ssteejans/thesis/Testing/Grid of Points/IMG_7849.JPG

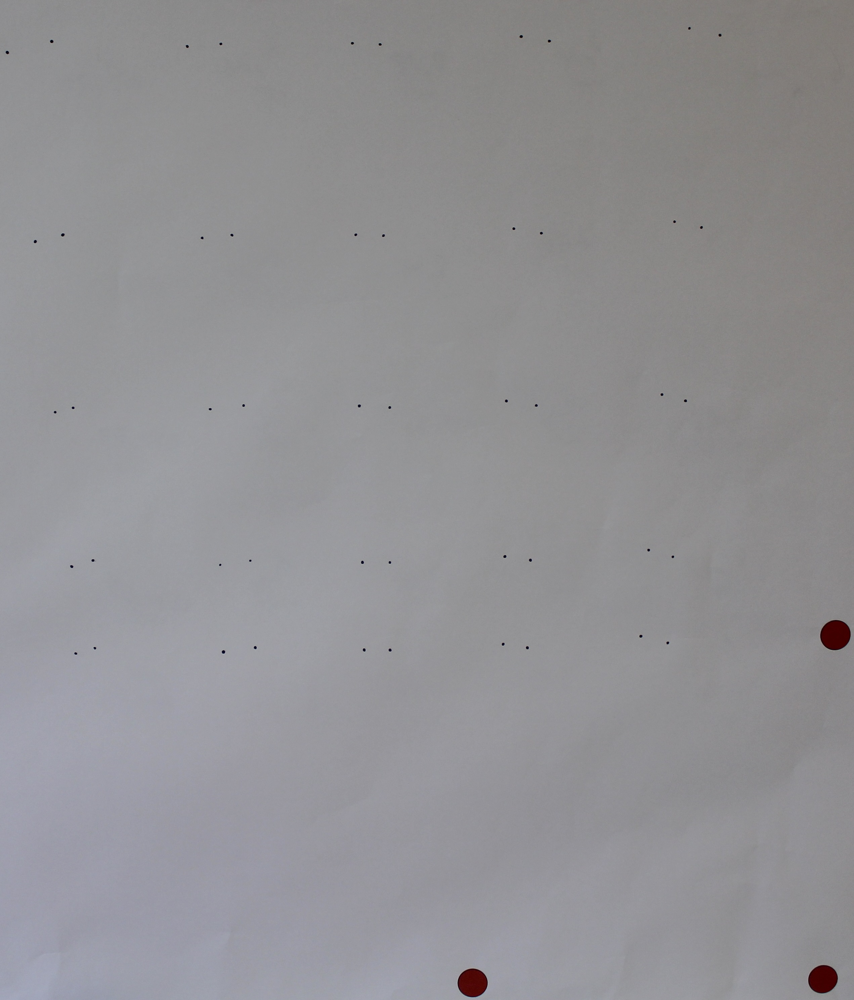
Testing/Grid of Points/IMG_7849.JPG
