ssteejans/thesis/Images/OTA Rotator.PNG

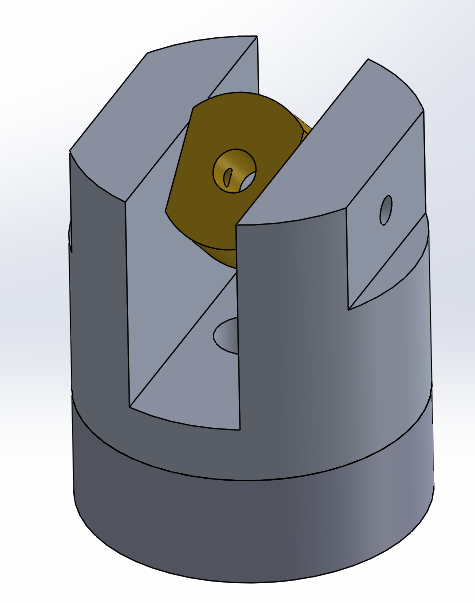
Images/OTA Rotator.PNG
