ssteejans/thesis/README.md

# thesis
Repository for thesis project
Author: Samuel Artho-Bentz
