ssteejans/thesis/Figures to be generated.rtf

To Do:
• Sections
o Title page
o Acknowledgement
o Abstract
o 2.1.3.2 angles of interest
o 2.1.3.3 Home Position
o 3.2.1 Time Derivative of a transformation matrix
o 3.3 Pointing a telescope
▪ RA/Dec to AltAz
o 4.2.1 Change from gear motor to stepper needs expanding
o 4.3.1 Talk about how to add micropython to board
o 4.3.3 What exactly the shoe of brian does
o 4.4 more discussion about advntages of python.
▪ discuss why Python is good for this system (easier and quicker development; easy for other users to modify; AstroPy provides LOTS of functionality; the system is generally slow so we don’t need the speed of C/C++/Assembly)
o All testing needs conclusions from each test
o 5.2.4 needs full description of wobble test
• Figures
o 5.2.2
▪ Frame capture of laser at starting point and ending point with note of time in between
• for each of the 4 tests
▪ Table with data
o 5.2.4
▪ lots of photos...but I need to figure out what the hell to do with this section

• Equations
o 3.2.1
▪ Time derivative of a transformation matrix
o 3.3
▪ Will need equations showing how latitude, longitude, right ascension, declination, and time -> altitude, azimuth, and rotation.
▪ http://aa.usno.navy.mil/faq/docs/Alt_Az.php
▪ http://spiff.rit.edu/classes/phys373/lectures/radec/radec.html
▪ http://ads.harvard.edu/books/1989fcm..book/Chapter2.pdf
o 4.2.1.3
• Things to do/discuss still
o Future Refinements & Summary should be combined into “Conclusions”
▪ Here is what I did
▪ Here are the results
▪ Here is what can be done to improve
• Refer to design section
• Automated homing
o Make sure all tests are well defined
▪ They all need discussion
▪ Quantify as much as possible
• Altitude Repeatability – “Repeatability was to within the tip of the marking pen, ~3mm”
• Explain any aberrations – starting point and repeating point are not the same – slop in system
• Altitude Relative Test
o Show plot of commanded angle vs angle error (Cmd-Actual)
o Develop design guidelines
▪ Geometry
• Modify matlab program for polar plot (theta-azimuth, r- altitude, hold image rotation to a constant angle)
▪ Linear Actuators
• What bearings are required
• How to pick motors
• Ball Screws vs Acme
▪ Rotators
• Compare to u-joint – get socket u joint to play with and think through if it would have singularity / other issues
• Bearings suggestions
o Appendices
▪ Doxygen Manual
• Doxygen.org to install doxygen
• doxypy or doxypypy to process files
• doxygen manual in appendix. code on github
▪ Drawings of any parts I made
• Frame
▪ Stepper motor spec sheet
• Ridgely
o Get instructions on adding Micropython to nucleo
o Shoe of Brian info for Appendices
• Presentation
o 25-40 min presentation followed by questions
o “Here is the thing I came up with” – just testing someone else’s stuff isn’t sufficient
▪ “I have created a design and test methodology”
o
