ssteejans/thesis/rotationMatrices.docx

RotX(θ)=[1, 0, 00, cosθ, -sinθ0, sinθ, cosθ]

RotZ(θ)=[cosθ, -sinθ, 0sinθ, cosθ, 00, 0, 1]

RotY(θ)=[cosθ, 0, sinθ0, 1, 0-sinθ, 0, cosθ]

sTb=[c(ϕ_(rot) ), -s(ϕ_(rot) ), 0s(ϕ_(rot) ), c(ϕ_(rot) ), 00, 0, 1][c(θ_(rot) ), -s(θ_(rot) ), 0s(θ_(rot) ), c(θ_(rot) ), 00, 0, 1][1, 0, 00, c(-θ_(alt) ), -s(-θ_(alt) )0, s(-θ_(alt) ), c(-θ_(alt) )]

[1, 0, 00, c(ϕ_(alt) ), -s(ϕ_(alt) )0, s(ϕ_(alt) ), c(ϕ_(alt) )][c(-θ_(az) ), 0, s(-θ_(az) )0, 1, 0-s(-θ_(az) ), 0, c(-θ_(az) )][c(ϕ_(az) ), 0, s(ϕ_(az) )0, 1, 0-s(ϕ_(az) ), 0, c(ϕ_(az) )]

θ_(altitude new) = θ_(altitude current) +ω_(altitude) *t_(step)

θ_(azimuth new) = θ_(azimuth current) +ω_(azimuth) *t_(step)

θ_(rotation new) = θ_(rotation current) +ω_(rotation) *t_(step)

L_(1 new) =f(θ_(altitude new) , θ_(azimuth new) , θ_(rotation new) )

V_1 =(L_(1 new) -L_(1 current))/(t_(step))
