ssteejans/thesis/Code/rtf/refman.rtf

Three Degree of Freedom Parallel Actuator Telescope Mount

AUTHOR
Version
Thu Jul 11 2019

Table of Contents

Table of contents

Hierarchical Index
Class Hierarchy
This inheritance list is sorted roughly, but not completely, alphabetically:
l6470nucleo.Dual6470 pagenum
object
ActuatorDriver.Actuator pagenum
TelescopeDriver.Telescope pagenum

Class Index
Class List
Here are the classes, structs, unions and interfaces with brief descriptions:
ActuatorDriver.Actuator (Object which represents one linear actuator for a 3 DOF parallel actuator telescope mount ) pagenum
l6470nucleo.Dual6470 (This class implements a driver for the dual L6470 stepping motor driver chips on a Nucleo IHM02A1 board ) pagenum
TelescopeDriver.Telescope (This class creates a telescope object controlled by 3 parallel actuators ) pagenum

File Index
File List
Here is a list of all documented files with brief descriptions:
ActuatorDriver.py (This file contains a driver for a linear actuator for use in a 3 DOF parallel actuator telescope mount ) pagenum
BitUtilities.py (Contains function to take the twos complement ) pagenum
l6470nucleo.py (This file contains a driver for a dual L6470 stepper driver board which is part of the Nucleo package from ST Micro ) pagenum
main.py (Control file for a Three Degree of Freedom Parallel Actuator Telescope Mount ) pagenum
TelescopeDriver.py (This file contains a driver for a Three Parallel actuator telescope ) pagenum

Class Documentation
ActuatorDriver.Actuator Class Reference
AAAAAAAABSAAAAAAAABS
Object which represents one linear actuator for a 3 DOF parallel actuator telescope mount.
Inheritance diagram for ActuatorDriver.Actuator:
IMAGE
Public Member Functions
def __init__ (self, stepPerLength, motorController, motorNumber)
Initialize the Actuator object.

def commandVelocity (self, velocity)
Commands the actuator to move at a specified velocity.

def commandLength (self, length)
Commands the actuator to move to a specific length.

def getCurrentLength (self)
Reads the stepcount of the motor and converts to length.

def findHome (self)
commands the actuator to slowly shorten.

def isHome (self)
Checks if the motor is stalled.

def resetPosition (self)
Defines the current position as zero steps.

def stop (self)
Commands the actuator to come to a soft stop.

Public Attributes
stepPerLength
The number of steps the stepper motor must take in order to move a distance.

controller
The motor controller associated with the actuator.

motorNumberAAAAAAAABTAAAAAAAABT
The motor to be used from the controller.

currentLengthAAAAAAAABUAAAAAAAABU
Variable to track the length of the actuator.

Detailed Description
Object which represents one linear actuator for a 3 DOF parallel actuator telescope mount.

Parameters:
stepPerLength | Total resolution of the actuator: STEPPER_RESOLUTION*SCREW_RESOLUTION*MICROSTEPS
motorController | Object which controls the motor: l6470nucleo.Dual6470
motorNumber | Motor selection for the l6470nucleo.Dual6470: 1 or 2

Constructor & Destructor Documentation
def ActuatorDriver.Actuator.__init__ ( self, stepPerLength, motorController, motorNumber)
AAAAAAAABVAAAAAAAABV
Initialize the Actuator object.

Member Function Documentation
ActuatorDriver.Actuator.commandLength ( self, length)
AAAAAAAABWAAAAAAAABW
Commands the actuator to move to a specific length.
Length unit is defined by the stepPerLength parameter.
Parameters:
length | [length]
ActuatorDriver.Actuator.commandVelocity ( self, velocity)
AAAAAAAABXAAAAAAAABX
Commands the actuator to move at a specified velocity.
Length unit is defined by the stepPerLength parameter.
Parameters:
velocity | [length/sec]
ActuatorDriver.Actuator.findHome ( self)
AAAAAAAABYAAAAAAAABY
commands the actuator to slowly shorten.
WARNING: no automatic stop is built into this function
ActuatorDriver.Actuator.getCurrentLength ( self)
AAAAAAAABZAAAAAAAABZ
Reads the stepcount of the motor and converts to length.

Returns:
currentLength the current length of the actuator
ActuatorDriver.Actuator.isHome ( self)
AAAAAAAACAAAAAAAAACA
Checks if the motor is stalled.
WARNING: results were not consistent and where very dependent on motor tuning.
ActuatorDriver.Actuator.resetPosition ( self)
AAAAAAAACBAAAAAAAACB
Defines the current position as zero steps.
Used for defining the home position.
ActuatorDriver.Actuator.stop ( self)
AAAAAAAACCAAAAAAAACC
Commands the actuator to come to a soft stop.

Member Data Documentation
ActuatorDriver.Actuator.controller
AAAAAAAACDAAAAAAAACD
The motor controller associated with the actuator.

ActuatorDriver.Actuator.stepPerLength
AAAAAAAACEAAAAAAAACE
The number of steps the stepper motor must take in order to move a distance.
Defines the units of length throughout the system.

The documentation for this class was generated from the following file:
ActuatorDriver.py

l6470nucleo.Dual6470 Class Reference
AAAAAAAACFAAAAAAAACF
This class implements a driver for the dual L6470 stepping motor driver chips on a Nucleo IHM02A1 board.
Public Member Functions
def __init__ (self, spi_object, cs_pin, stby_rst_pin)
Initialize the Dual L6470 driver.

def run (self, motor, steps_per_sec)
Tell the motor to run at the given speed.

def StepClock (self, direc=None)
Switch the motor to StepClock mode.

def Move (self, motor, steps, direc=None)
Tell motor driver motor to move num_steps in the direction direction .

def GoTo (self, motor, pos_steps)
This command asks the specified motor to move to the specified position.

def GoTo_DIR (self, motor, pos_steps, direc)
NOT IMPLEMENTED

def GoUntil (self, motor, action, steps_per_sec, direction)
NOT IMPLEMENTED

def ReleaseSW (self, motor, action, direc)
NOT IMPLEMENTED

def GoHome (self, motor)
NOT IMPLEMENTED

def GoMark (self, motor)
NOT IMPLEMENTED

def ResetPos (self, motor)
This command sets the given motor driver's absolute position register to zero.

def ResetDevice (self, motor)
NOT IMPLEMENTED

def softStop (self, motor)
Tell a motor driver to decelerate its motor and stop wherever it ends up after the deceleration.

def HardStop (self, motor)
Tell the specified motor to stop immediately, not even doing the usual smooth deceleration.

def SoftHiZ (self, motor)
Tell the specified motor to decelerate smoothly from its motion, then put the power bridges in high-impedance mode, turning off power to the motor.

def HardHiZ (self, motor)
Tell the specified motor to stop and go into high-impedance mode (no current is applied to the motor coils) immediately, not even doing the usual smooth deceleration.

def GetStatus (self, motor, verbose=0)
Gets the value of the STATUS register for the specified motor .

def getPositions (self, motor)
Get the positions stored in the drivers for the selected motor.

def isStalled (self, motor, homing=False)
Checks if the specified motor is stalled.

def Print_Status (self, motor, status)
Formatted printing of status codes for the driver.

Public Attributes
cs_pin
The CPU pin connected to the Chip Select (AKA 'Slave Select') pin of both the L6470 drivers.

stby_rst_pin
The CPU pin connected to the STBY/RST pin of the 6470's.

spi
The SPI object, configured with parameters that work for L6470's.

Static Public Attributes
dictionary REGISTER_DICT = {}
Dictionary of user available registers and their addresses.

dictionary STATUS_DICT = {}
Dictionary for the STATUS register.

dictionary COMMAND_DICT = {}
Dictionary for Application Commands.

Detailed Description
This class implements a driver for the dual L6470 stepping motor driver chips on a Nucleo IHM02A1 board.
The two driver chips are connected in SPI daisy-chain mode, which makes communication a bit convoluted.
NOTE: One solder bridge needs to be moved for the IHM02A1 to work with unmodified MicroPython. Bridge SB34 must be disconnected, and bridge SB12 must be connected instead. This is because the SCK signal for which the board is shipped is not the one which MicroPython uses by default.
Parameters:
spi_object | A SPI object already initialized. used to talk to the driver chips, either 1 or 2 for most Nucleos
cs_pin | The pin which is connected to the driver chips' SPI chip select (or 'slave select') inputs, in a pyb.Pin object
stby_rst_pin | The pin which is connected to the driver chips' STBY/RST inputs, in a pyb.Pin object

Constructor & Destructor Documentation
def l6470nucleo.Dual6470.__init__ ( self, spi_object, cs_pin, stby_rst_pin)
AAAAAAAACGAAAAAAAACG
Initialize the Dual L6470 driver.
The modes of the CS and STBY/RST pins are set and the SPI port is set up correctly.

Member Function Documentation
l6470nucleo.Dual6470.getPositions ( self, motor)
AAAAAAAACHAAAAAAAACH
Get the positions stored in the drivers for the selected motor.
Each driver stores its motor's position in a 22-bit register. If only one position is needed, it's efficient to get both because the drivers are daisy-chained on the SPI bus, so we have to send two commands and read a bunch of bytes of data anyway.
Parameters:
motor | The motor whose position should be read, 1 or 2
Returns: The current positions of the selected motor
l6470nucleo.Dual6470.GetStatus ( self, motor, verbose = 0)
AAAAAAAACIAAAAAAAACI
Gets the value of the STATUS register for the specified motor .
Resets STATUS register warning flags. Exits the system from error state. Does not reset HiZ.
WARNING: resets warning flags and error state for both steppers attached to the L6470 Nucleo.
Parameters:
motor | The motor whose status register should be read, 1 or 2
verbose | Print the status register results if TRUE
l6470nucleo.Dual6470.GoHome ( self, motor)
AAAAAAAACJAAAAAAAACJ
NOT IMPLEMENTED

l6470nucleo.Dual6470.GoMark ( self, motor)
AAAAAAAACKAAAAAAAACK
NOT IMPLEMENTED

l6470nucleo.Dual6470.GoTo ( self, motor, pos_steps)
AAAAAAAACLAAAAAAAACL
This command asks the specified motor to move to the specified position.

Parameters:
motor | The motor to move, either 1 or 2
pos_steps | The position to which to move, in absolute steps
l6470nucleo.Dual6470.GoTo_DIR ( self, motor, pos_steps, direc)
AAAAAAAACMAAAAAAAACM
NOT IMPLEMENTED

l6470nucleo.Dual6470.GoUntil ( self, motor, action, steps_per_sec, direction)
AAAAAAAACNAAAAAAAACN
NOT IMPLEMENTED

l6470nucleo.Dual6470.HardHiZ ( self, motor)
AAAAAAAACOAAAAAAAACO
Tell the specified motor to stop and go into high-impedance mode (no current is applied to the motor coils) immediately, not even doing the usual smooth deceleration.
This command puts the motor into a freewheeling mode with no control of position except for the small holding torque from the magnets in a PM hybrid stepper. This will probably cause the motor to miss some steps and have an inaccurate position count.
Parameters:
motor | The motor to be turned off, 1 or 2
l6470nucleo.Dual6470.HardStop ( self, motor)
AAAAAAAACPAAAAAAAACP
Tell the specified motor to stop immediately, not even doing the usual smooth deceleration.
This command asks for nearly infinite acceleration of the motor, and will probably cause the motor to miss some steps and have an inaccurate position count.
Parameters:
motor | The motor to halt, 1 or 2
l6470nucleo.Dual6470.isStalled ( self, motor, homing = False)
AAAAAAAACQAAAAAAAACQ
Checks if the specified motor is stalled.
Did not work with all motors. Should be tested heavily before use.
Parameters:
motor | The motor to check for stall
homing | If TRUE, reset position when stalled
l6470nucleo.Dual6470.Move ( self, motor, steps, direc = None)
AAAAAAAACRAAAAAAAACR
Tell motor driver motor to move num_steps in the direction direction .

Parameters:
motor | The motor to move, either 1 or 2
steps | How many steps to move, in a 20 bit number
direc | The direction in which to move, either 0 for one way or nonzero for the other; if unspecified, the sign of the number of steps will be used, positive meaning direction 0
l6470nucleo.Dual6470.Print_Status ( self, motor, status)
AAAAAAAACSAAAAAAAACS
Formatted printing of status codes for the driver.

Parameters:
motor | The motor which the status is representing.
status | The code returned by a GetStatus call.
l6470nucleo.Dual6470.ReleaseSW ( self, motor, action, direc)
AAAAAAAACTAAAAAAAACT
NOT IMPLEMENTED

l6470nucleo.Dual6470.ResetDevice ( self, motor)
AAAAAAAACUAAAAAAAACU
NOT IMPLEMENTED

l6470nucleo.Dual6470.ResetPos ( self, motor)
AAAAAAAACVAAAAAAAACV
This command sets the given motor driver's absolute position register to zero.

Parameters:
motor | The motor whose position is to be zeroed, either 1 or 2
l6470nucleo.Dual6470.run ( self, motor, steps_per_sec)
AAAAAAAACWAAAAAAAACW
Tell the motor to run at the given speed.
The speed may be positive, causing the motor to run in direction 0, or negative, causing the motor to run in direction 1.
Parameters:
motor | The motor to move, either 1 or 2
steps_per_sec | The number of steps per second at which to go, up to the maximum allowable set in MAX_SPEED
l6470nucleo.Dual6470.SoftHiZ ( self, motor)
AAAAAAAACXAAAAAAAACX
Tell the specified motor to decelerate smoothly from its motion, then put the power bridges in high-impedance mode, turning off power to the motor.

Parameters:
motor | The motor to be turned off, 1 or 2
l6470nucleo.Dual6470.softStop ( self, motor)
AAAAAAAACYAAAAAAAACY
Tell a motor driver to decelerate its motor and stop wherever it ends up after the deceleration.

Parameters:
motor | The motor to halt, 1 or 2
l6470nucleo.Dual6470.StepClock ( self, direc = None)
AAAAAAAACZAAAAAAAACZ
Switch the motor to StepClock mode.

In StepClock mode the motor moves in response to the rising edge of a signal applied to the STCK pin.
NOT IMPLEMENTED
Parameters:
direc | Direction in which the motor should move on rising edge

Member Data Documentation
dictionary l6470nucleo.Dual6470.COMMAND_DICT = {}[static]
AAAAAAAADAAAAAAAAADA
Dictionary for Application Commands.
See L6470 Programming manual Pg 56 for information on usage. These commands must be OR'd with the values for use.
l6470nucleo.Dual6470.cs_pin
AAAAAAAADBAAAAAAAADB
The CPU pin connected to the Chip Select (AKA 'Slave Select') pin of both the L6470 drivers.

dictionary l6470nucleo.Dual6470.REGISTER_DICT = {}[static]
AAAAAAAADCAAAAAAAADC
Dictionary of user available registers and their addresses.

l6470nucleo.Dual6470.spi
AAAAAAAADDAAAAAAAADD
The SPI object, configured with parameters that work for L6470's.
pyb.SPI (spi_number, mode=pyb.SPI.MASTER, baudrate=2000000, polarity=1, phase=1, bits=8, firstbit=pyb.SPI.MSB)
dictionary l6470nucleo.Dual6470.STATUS_DICT = {}[static]
AAAAAAAADEAAAAAAAADE
Dictionary for the STATUS register.
Contains all error flags, as well as basic motor state information.
l6470nucleo.Dual6470.stby_rst_pin
AAAAAAAADFAAAAAAAADF
The CPU pin connected to the STBY/RST pin of the 6470's.

The documentation for this class was generated from the following file:
l6470nucleo.py

TelescopeDriver.Telescope Class Reference
AAAAAAAADGAAAAAAAADG
This class creates a telescope object controlled by 3 parallel actuators.
Inheritance diagram for TelescopeDriver.Telescope:
IMAGE
Public Member Functions
def __init__ (self, actuatorOne, actuatorTwo, actuatorThree)AAAAAAAADHAAAAAAAADH
Initialize the Telescope object.

def goVelocityAngular (self, omega_alt, omega_az, omega_rot, tstep=1)
Move the telescope at specified radians/sec.

def goToAngles (self, O_alt, O_az, O_rot, move=False)
Function which calculates the correct lengths of the three linear actuators in order to achieve the specified angles (in degrees) then can send the scope to that location.

def findHome (self)
Causes each actuator to shorten until it stalls then stops WARNING: Does not function!

def resetPositions (self)
Zeros the absolute position of each actuator.

def goToLengths (self, lengthOne, lengthTwo, lengthThree)
Commands each actuator to a specified length.

def goVelocity (self, velOne, velTwo, velThree)
Commands each actuator to move at a specified velocity.

Public Attributes
actuatorOneAAAAAAAADIAAAAAAAADI
actuatorOne: Right actuator when viewed from the origin looking along the X axis

actuatorTwoAAAAAAAADJAAAAAAAADJ
actuatorTwo: Left actuator when viewed from the origin looking along the X axis

actuatorThreeAAAAAAAADKAAAAAAAADK
actuatorThree: Rear, horizontal actuator

P0_bAAAAAAAADLAAAAAAAADL
Origin with respect to the base.

P1_bAAAAAAAADMAAAAAAAADM
Fixed end of actuator one.

P2_bAAAAAAAADNAAAAAAAADN
Fixed end of actuator two.

P3_bAAAAAAAADOAAAAAAAADO
Fixed end of actuator three.

OA_bAAAAAAAADPAAAAAAAADP
Optical Axis base.

P1_hAAAAAAAADQAAAAAAAADQ
Position of the moving end of actuator one in the home position.

P2_hAAAAAAAADRAAAAAAAADR
Position of the moving end of actuator two in the home position.

P3_hAAAAAAAADSAAAAAAAADS
Position of the moving end of actuator three in the home position.

OA_hAAAAAAAADTAAAAAAAADT
Position of the moving end of optical axis in the home position.

L_p1minAAAAAAAADUAAAAAAAADU
Minimum length of actuator one.

L_p2minAAAAAAAADVAAAAAAAADV
Minimum length of actuator two.

L_p3minAAAAAAAADWAAAAAAAADW
Minimum length of actuator three.

L_p1p2AAAAAAAADXAAAAAAAADX
Fixed distance from the moving end of actuator one to actuator two.

phi_azAAAAAAAADYAAAAAAAADY
The azimuth correction angle required to rotate from the home position to (0,0,0)

phi_altAAAAAAAADZAAAAAAAADZ
The altitude correction angle required to rotate from the home position to (0,0,0)

phi_rotAAAAAAAAEAAAAAAAAAEA
The image rotation correction angle required to rotate from the home position to (0,0,0)

alt_curAAAAAAAAEBAAAAAAAAEB
The current altitude of the system.

az_curAAAAAAAAECAAAAAAAAEC
The current azimuth of the system.

rot_curAAAAAAAAEDAAAAAAAAED
The current image rotation of the system.

Detailed Description
This class creates a telescope object controlled by 3 parallel actuators.
Each actuator is driven by a stepper motor with an L6470 stepper driver.
Parameters:
actuatorOne | Right actuator when viewed from the origin looking along the X axis
actuatorTwo | Left actuator when viewed from the origin looking along the X axis
actuatorThree | Rear, horizontal actuator

Member Function Documentation
TelescopeDriver.Telescope.findHome ( self)
AAAAAAAAEEAAAAAAAAEE
Causes each actuator to shorten until it stalls then stops WARNING: Does not function!
Non-functioning function which is designed to implement automatic home checking
TelescopeDriver.Telescope.goToAngles ( self, O_alt, O_az, O_rot, move = False)
AAAAAAAAEFAAAAAAAAEF
Function which calculates the correct lengths of the three linear actuators in order to achieve the specified angles (in degrees) then can send the scope to that location.

Parameters:
O_alt | Desired Altitude Angle in radians
O_az | Desired Azimuth Angle in radians
O_rot | Desired Rotation Angle in radians
move | Boolean value which determines if the function only calculates the required lengths or also commands motion
TelescopeDriver.Telescope.goToLengths ( self, lengthOne, lengthTwo, lengthThree)
AAAAAAAAEGAAAAAAAAEG
Commands each actuator to a specified length.

Parameters:
lengthOne | Desired length for actuator one
lengthTwo | Desired length for actuator two
lengthThree | Desired length for actuator three
TelescopeDriver.Telescope.goVelocity ( self, velOne, velTwo, velThree)
AAAAAAAAEHAAAAAAAAEH
Commands each actuator to move at a specified velocity.

Parameters:
velOne | Velocity in length/sec
velTwo | Velocity in length/sec
velThree | Velocity in length/sec
TelescopeDriver.Telescope.goVelocityAngular ( self, omega_alt, omega_az, omega_rot, tstep = 1)
AAAAAAAAEIAAAAAAAAEI
Move the telescope at specified radians/sec.

Parameters:
omega_az | Angular rate of azimuth (Rad/sec)
omega_alt | Angular rate of altitude (Rad/sec)
omega_rot | Angular rate of image rotation (Rad/sec)
tstep | time step for calculation of velocity. Default 1 sec
TelescopeDriver.Telescope.resetPositions ( self)
AAAAAAAAEJAAAAAAAAEJ
Zeros the absolute position of each actuator.
Used for defining the home position.

The documentation for this class was generated from the following file:
TelescopeDriver.py

File Documentation
ActuatorDriver.py File Reference
AAAAAAAAAAAAAAAAAAAA
This file contains a driver for a linear actuator for use in a 3 DOF parallel actuator telescope mount.
Classes
class ActuatorDriver.Actuator
Object which represents one linear actuator for a 3 DOF parallel actuator telescope mount.

Detailed Description
This file contains a driver for a linear actuator for use in a 3 DOF parallel actuator telescope mount.

Author:
Samuel Steejans Artho-Bentz

BitUtilities.py File Reference
AAAAAAAAABAAAAAAAAAB
Contains function to take the twos complement.
Functions
def BitUtilities.GetTwosComplement (value, bits)AAAAAAAAACAAAAAAAAAC
Takes the twos complement.

Detailed Description
Contains function to take the twos complement.

Author:
: mecha31

l6470nucleo.py File Reference
AAAAAAAAADAAAAAAAAAD
This file contains a driver for a dual L6470 stepper driver board which is part of the Nucleo package from ST Micro.
Classes
class l6470nucleo.Dual6470
This class implements a driver for the dual L6470 stepping motor driver chips on a Nucleo IHM02A1 board.
Variables
l6470nucleo.MAX_SPEED = const (10)AAAAAAAAAEAAAAAAAAAE
Maximum speed for the motor; default 65, or ~992 steps/s.

l6470nucleo.ACCEL = const (12)AAAAAAAAAFAAAAAAAAAF
Acceleration for the motor; default 138, or 2008 steps/s^2.

l6470nucleo.DECEL = const (12)AAAAAAAAAGAAAAAAAAAG
Deceleration for the motor; default 138, or 2008 steps/s^2.

l6470nucleo.K_VAL = const (255)AAAAAAAAAHAAAAAAAAAH
The K_val constant for registers 0x09, 0x0A, 0x0B, 0x0C; default 0x29 = 41.

l6470nucleo.INT_SPEED = const (2307)AAAAAAAAAIAAAAAAAAAI
Intersection speed for register 0x0D; default 0x0408 = 1032.

l6470nucleo.ST_SLP = const (25)AAAAAAAAAJAAAAAAAAAJ
Startup slope for register 0x0E; default 0x19 = 25.

l6470nucleo.FN_SLP = const (255)AAAAAAAAAKAAAAAAAAAK
Final slope for registers 0x0F, 0x10; default 0x29 = 41.

int l6470nucleo.STEP_SEL = 4
Number of Microsteps, num which are powers of 2 up to 128 are acceptable.

l6470nucleo.SYNC_EN = const(0x00)
Define SYNC_ENable bitmask.

l6470nucleo.SYNC_SEL = const(0x10)
SYNC_SEL modes.

l6470nucleo.STALL_TH = const(13)
STALL_TH.

Detailed Description
This file contains a driver for a dual L6470 stepper driver board which is part of the Nucleo package from ST Micro.
It can control each of the two L5470 chips which are on the board.
In order to use a stepping motor, the constants MAX_SPEED , ACCEL , etc . need to be tuned for that motor using the methods shown at http://www.st.com/resource/en/application_note/dm00061093.pdf .
Author:
JR Ridgely, Samuel Steejans Artho-Bentz

Variable Documentation
l6470nucleo.STALL_TH = const(13)
AAAAAAAAALAAAAAAAAAL
STALL_TH.
Default of 2.03A pg 47 of L6470 Programming Manual for details
int l6470nucleo.STEP_SEL = 4
AAAAAAAAAMAAAAAAAAAM
Number of Microsteps, num which are powers of 2 up to 128 are acceptable.

l6470nucleo.SYNC_EN = const(0x00)
AAAAAAAAANAAAAAAAAAN
Define SYNC_ENable bitmask.
0x80 for High, 0x00 for Low
l6470nucleo.SYNC_SEL = const(0x10)
AAAAAAAAAOAAAAAAAAAO
SYNC_SEL modes.
Datasheet pg 46 for full information

main.py File Reference
AAAAAAAAAPAAAAAAAAAP
Control file for a Three Degree of Freedom Parallel Actuator Telescope Mount.
Functions
def main.estop ()
commands all motors to halt immediately.

def main.Go (speed)
commands all motors to go at the specified speed.

def main.getPos ()AAAAAAAAAQAAAAAAAAAQ
Queries the actuators for their current lengths.

def main.getStatus (motornumber)
Requests the status of the specified motor.

def main.testRepeatability (numloops=10)
Runs through a series of points numloops times.

def main.testGrid ()
Moves to a series of points and waits for user input at each one.

Variables
main.STEPPER_RESOLUTION = const (200)AAAAAAAAARAAAAAAAAAR
Stepper Resolution [steps/rev].

int main.MICROSTEPS = 4AAAAAAAAASAAAAAAAAAS
Number of microsteps This must match NUMBER_OF_MICROSTEPS in TelescopeDriver.py and STEP_SEL in l6470nucleo.py .

main.SCREW_RESOLUTION = const(16)AAAAAAAAATAAAAAAAAAT
Leadscrew Resolution [rev/in].

main.stby_rst_pin1 = pyb.Pin.cpu.B5AAAAAAAAAUAAAAAAAAAU
SPI one standby/reset pin.

main.stby_rst_pin2 = pyb.Pin.cpu.B3AAAAAAAAAVAAAAAAAAAV
SPI two standyby/reset pin.

main.nCS1 = pyb.Pin.cpu.A4AAAAAAAAAWAAAAAAAAAW
SPI one chip select pin.

main.nCS2 = pyb.Pin.cpu.A10AAAAAAAAAXAAAAAAAAAX
SPI two chip select pin.

int main.spi_number = 1AAAAAAAAAYAAAAAAAAAY
SPI number.

main.spi_object
spi object for motor drivers

main.Driver1 = l6470nucleo.Dual6470(spi_object,nCS1, stby_rst_pin1)AAAAAAAAAZAAAAAAAAAZ
l6470nucleo board object

main.Driver2 = l6470nucleo.Dual6470(spi_object,nCS2, stby_rst_pin2)AAAAAAAABAAAAAAAAABA
l6470nucleo board object

main.actuatorOne = ActuatorDriver.Actuator(STEPPER_RESOLUTION*SCREW_RESOLUTION*MICROSTEPS, Driver1, 1)AAAAAAAABBAAAAAAAABB
Right actuator when viewed from the origin looking along the X axis.

main.actuatorTwo = ActuatorDriver.Actuator(STEPPER_RESOLUTION*SCREW_RESOLUTION*MICROSTEPS, Driver1, 2)AAAAAAAABCAAAAAAAABC
Left actuator when viewed from the origin looking along the X axis.

main.actuatorThree = ActuatorDriver.Actuator(STEPPER_RESOLUTION*SCREW_RESOLUTION*MICROSTEPS, Driver2, 1)AAAAAAAABDAAAAAAAABD
Rear, horizontal actuator.

main.Telescope = TelescopeDriver.Telescope(actuatorOne, actuatorTwo, actuatorThree)AAAAAAAABEAAAAAAAABE
Define the telescope based on the actuators above.

Detailed Description
Control file for a Three Degree of Freedom Parallel Actuator Telescope Mount.

Author:
Samuel Steejans Artho-Bentz

Function Documentation
main.estop ()
AAAAAAAABFAAAAAAAABF
commands all motors to halt immediately.

def main.getStatus ( motornumber)
AAAAAAAABGAAAAAAAABG
Requests the status of the specified motor.

Parameters:
motornumber | The motor associated with the desired actuator: 1, 2, or 3
def main.Go ( speed)
AAAAAAAABHAAAAAAAABH
commands all motors to go at the specified speed.
directly communicates with the stepper motors.
Parameters:
speed | steps/second
main.testGrid ()
AAAAAAAABIAAAAAAAABI
Moves to a series of points and waits for user input at each one.
Used for testing.
def main.testRepeatability ( numloops = 10)
AAAAAAAABJAAAAAAAABJ
Runs through a series of points numloops times.
Waits for the user to hit a key before moving on to the next point. Used for testing.
Parameters:
numloops | Desired number of times the points should be gone through.

Variable Documentation
main.spi_object
AAAAAAAABKAAAAAAAABKInitial value: 1 = pyb.SPI (spi_number, mode=pyb.SPI.MASTER,
2 baudrate=2000000, polarity=1, phase=1,
3 bits=8, firstbit=pyb.SPI.MSB)
spi object for motor drivers

TelescopeDriver.py File Reference
AAAAAAAABLAAAAAAAABL
This file contains a driver for a Three Parallel actuator telescope.
Classes
class TelescopeDriver.Telescope
This class creates a telescope object controlled by 3 parallel actuators.
Functions
def TelescopeDriver.rootsumsquare (a, b)
Calculates the root sum square of two vectors of size 3.

def TelescopeDriver.matmul (a, b)
Multiplies two matrices together a * b .

def TelescopeDriver.RotX (rads)AAAAAAAABMAAAAAAAABM
Rotation matrix about the x axis.

def TelescopeDriver.RotY (rads)AAAAAAAABNAAAAAAAABN
Rotation matrix about the y axis.

def TelescopeDriver.RotZ (rads)AAAAAAAABOAAAAAAAABO
Rotation matrix about the z axis.

Variables
int TelescopeDriver.NUMBER_OF_MICROSTEPS = 4AAAAAAAABPAAAAAAAABP
Must define the number of microsteps to correct for oddity of stepper driver.

Detailed Description
This file contains a driver for a Three Parallel actuator telescope.

Author:
Samuel Steejans Artho-Bentz

Function Documentation
def TelescopeDriver.matmul ( a, b)
AAAAAAAABQAAAAAAAABQ
Multiplies two matrices together a * b .

Parameters:
a | [m x n] matrix
b | [n x o] matrix
def TelescopeDriver.rootsumsquare ( a, b)
AAAAAAAABRAAAAAAAABR
Calculates the root sum square of two vectors of size 3.

Parameters:
a | vector of size 3
b | vector of size 3
Returns: The root-sum-of-squares of the difference of a and b

Index
INDEX
