ssteejans/thesis/Thesis Solidmodel/8020Frame - Sheet1.pdf

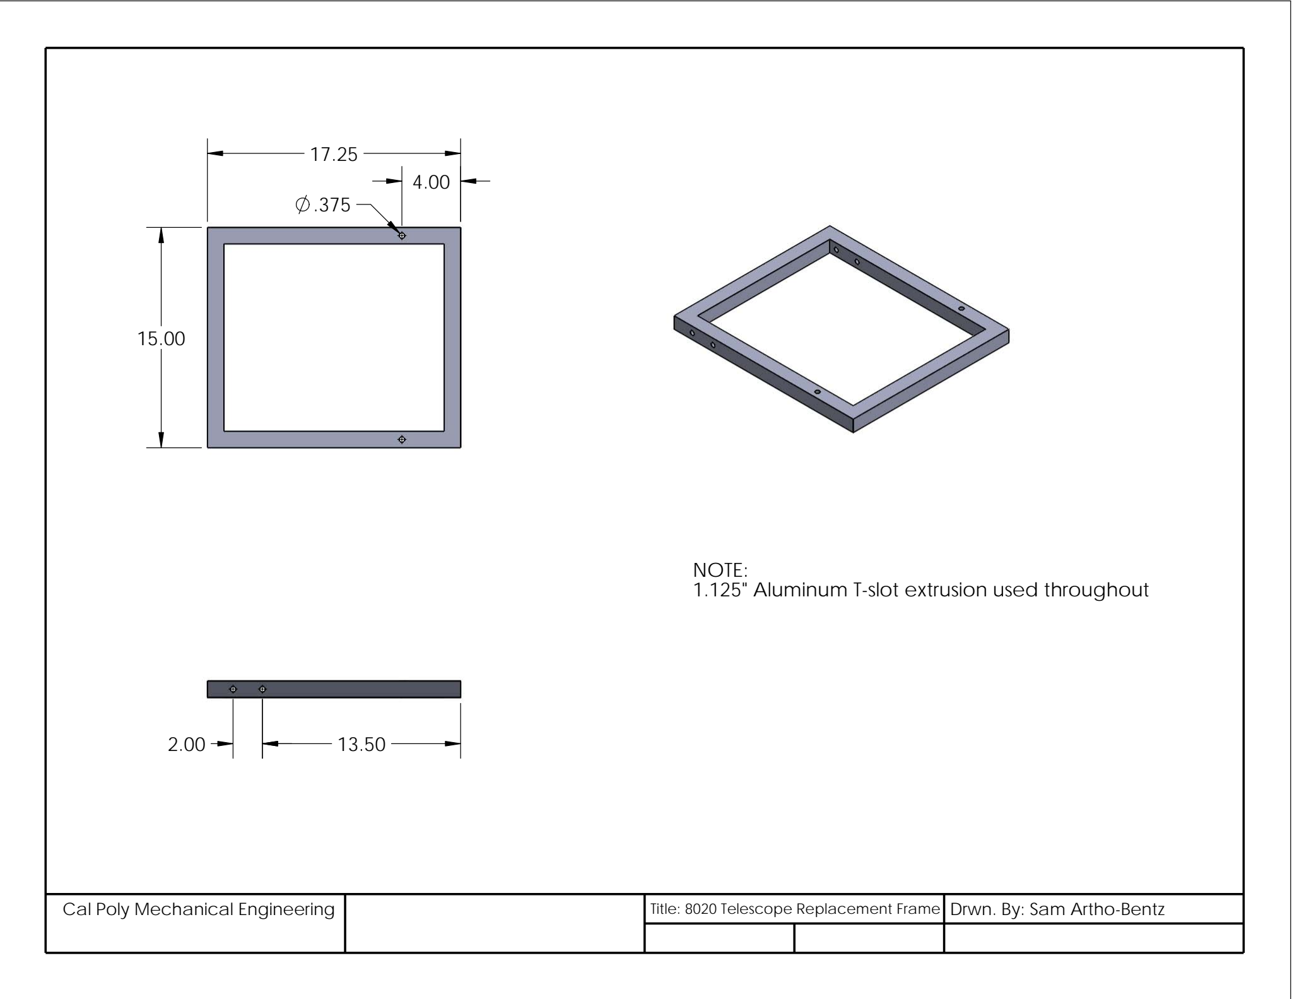
[picture p58: page 1]

2.00 | 13.50

4.00

17.25

15.00

.375

NOTE:
1.125" Aluminum T-slot extrusion used throughout
Cal Poly Mechanical Engineering | Title: 8020 Telescope Replacement Frame | Drwn. By: Sam Artho-Bentz
