ssteejans/thesis/Thesis Solidmodel/Dropdown - Sheet1.pdf

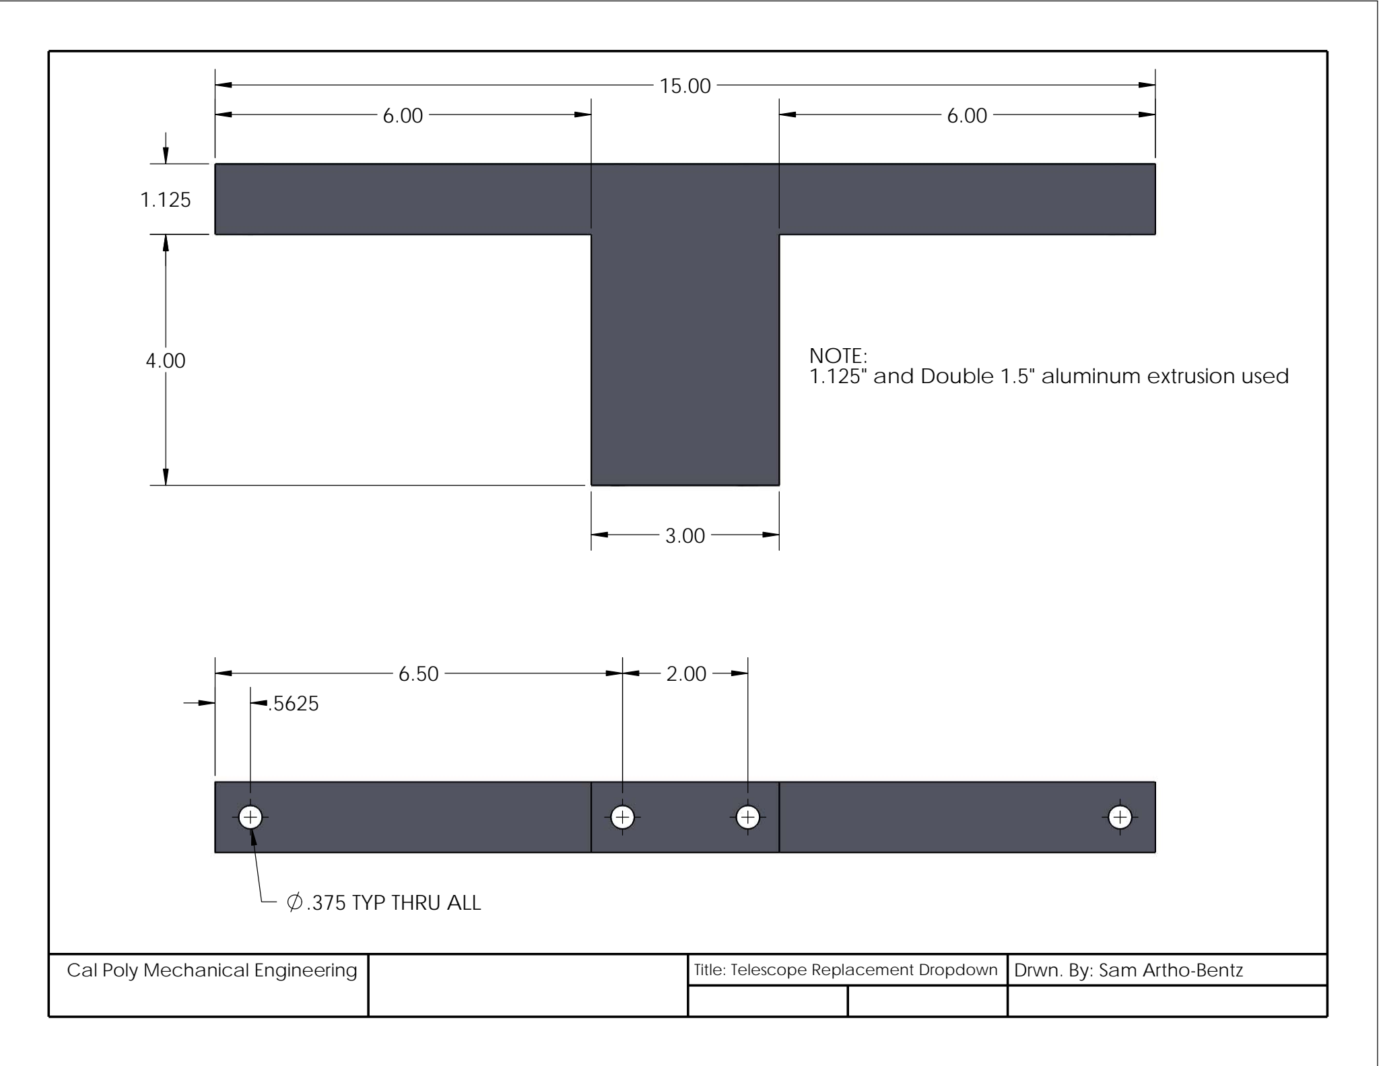
[picture p59: page 1]

Cal Poly Mechanical Engineering | Title: Telescope Replacement Dropdown | Drwn. By: Sam Artho-Bentz

NOTE:
1.125" and Double 1.5" aluminum extrusion used

6.00

15.00

1.125

3.00

4.00

6.00

6.50
.5625

2.00

.375 TYP THRU ALL
