ssteejans/thesis/Thesis Solidmodel/Backplate - Sheet1.pdf

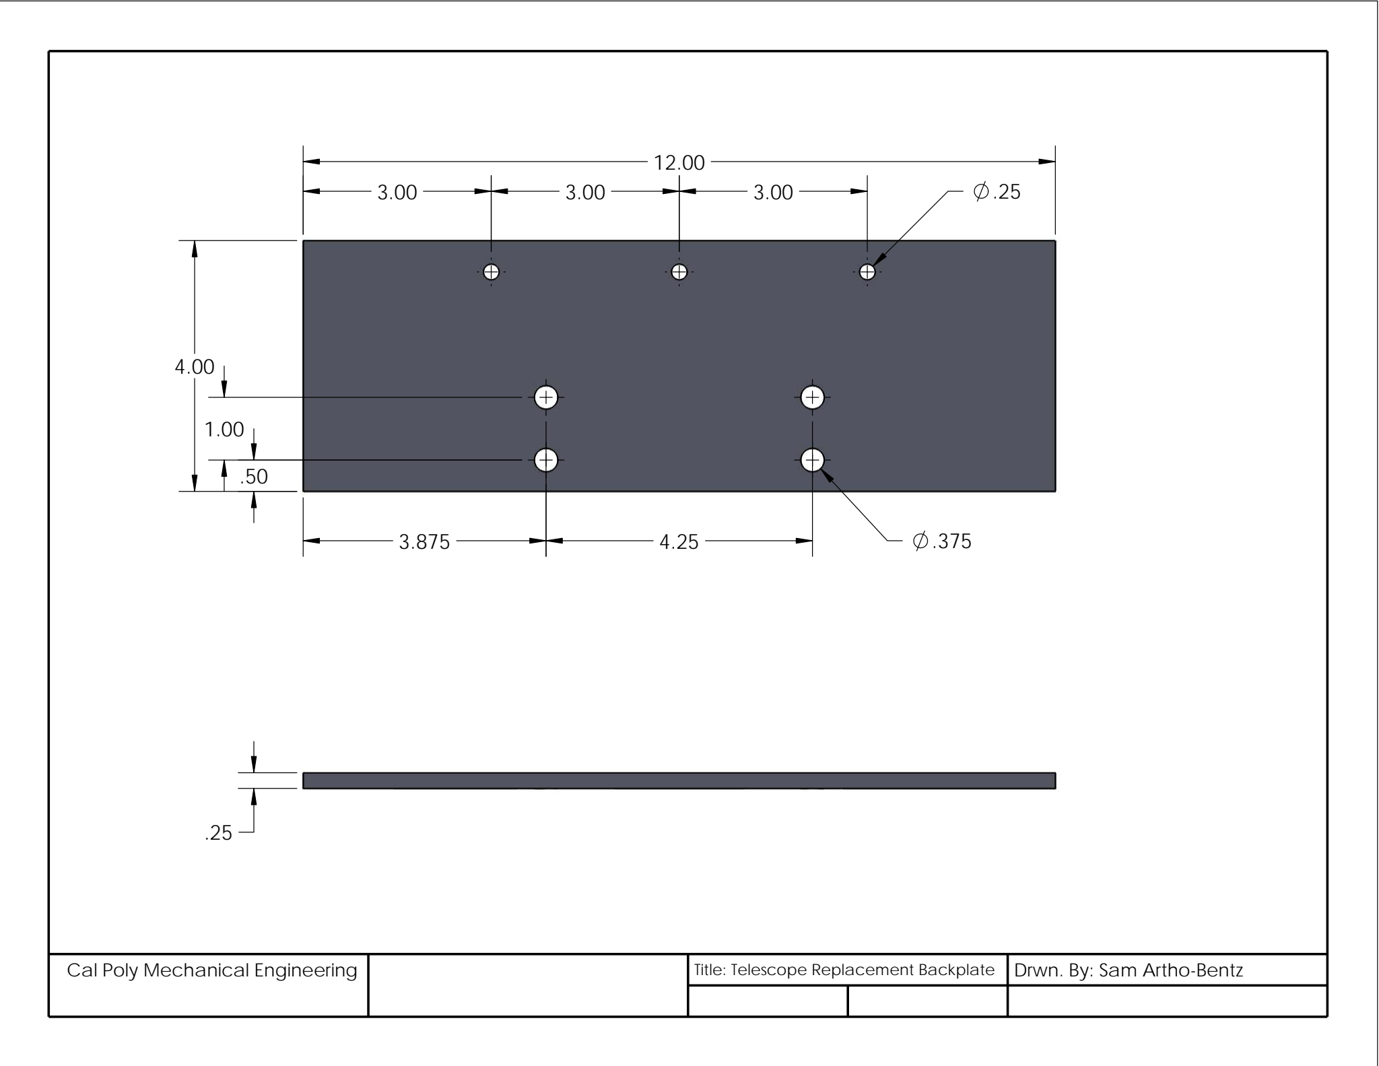
[picture p98: page 1]

Cal Poly Mechanical Engineering | Title: Telescope Replacement Backplate | Drwn. By: Sam Artho-Bentz

.375

4.00

12.00
3.00 | 3.00 | 3.00

4.25

1.00

.50

3.875

.25

.25
