ssteejans/thesis/Images/Board Trig.pdf

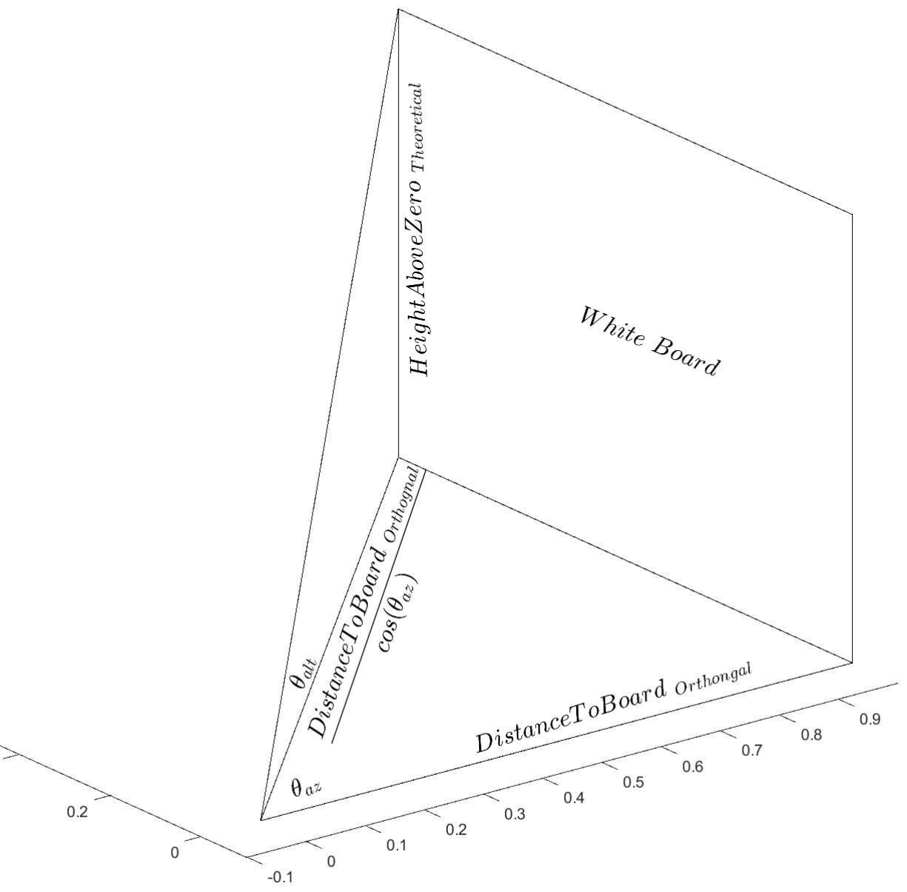
[picture p99: page 1]
