ssteejans/thesis/Images/Board Trig2.pdf

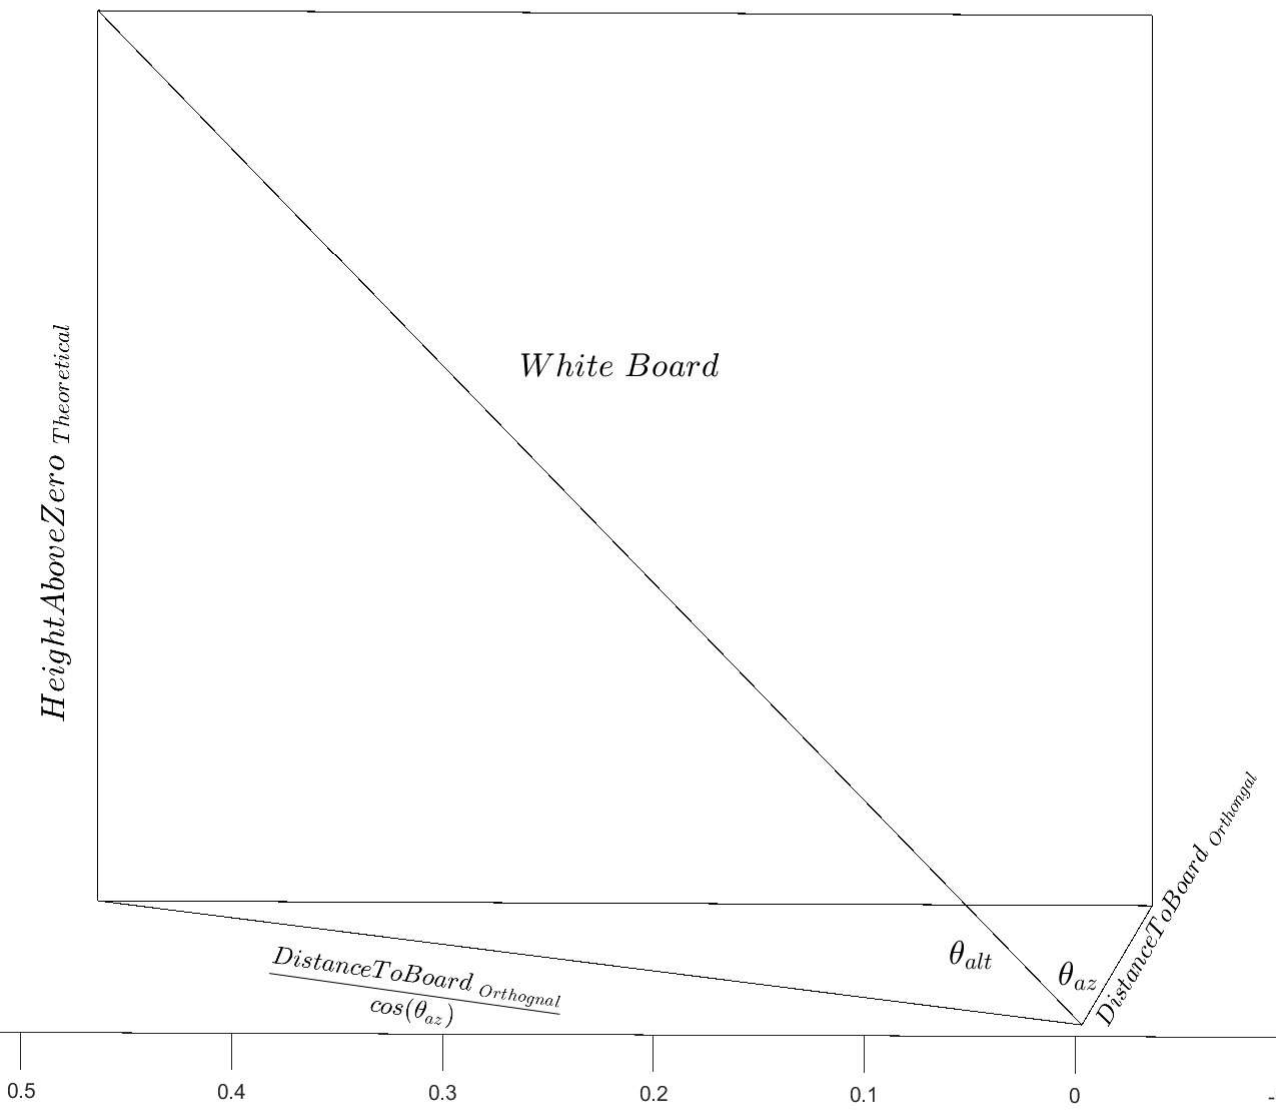
[picture p100: page 1]
