ssteejans/thesis/Images/Base Rotater.PNG

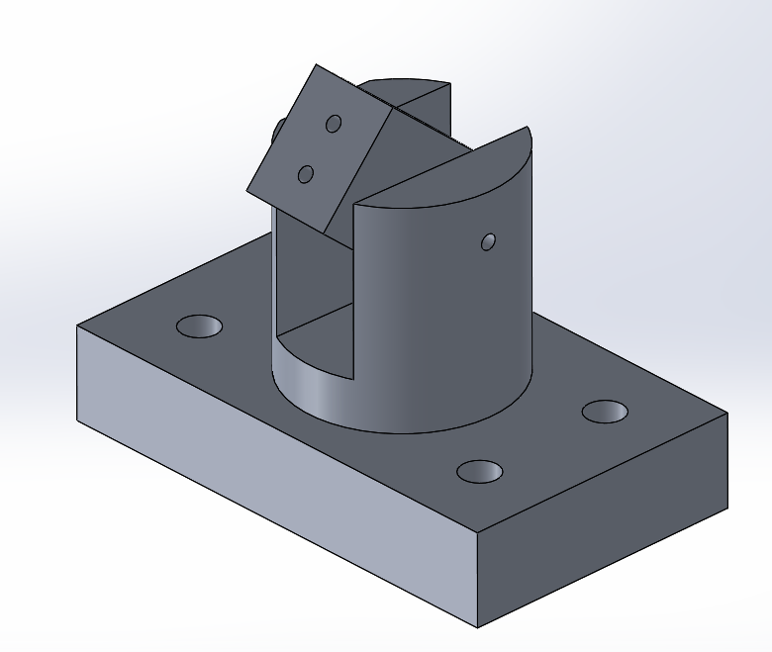
Images/Base Rotater.PNG
