ssteejans/thesis/Images/Board Trig-1.png

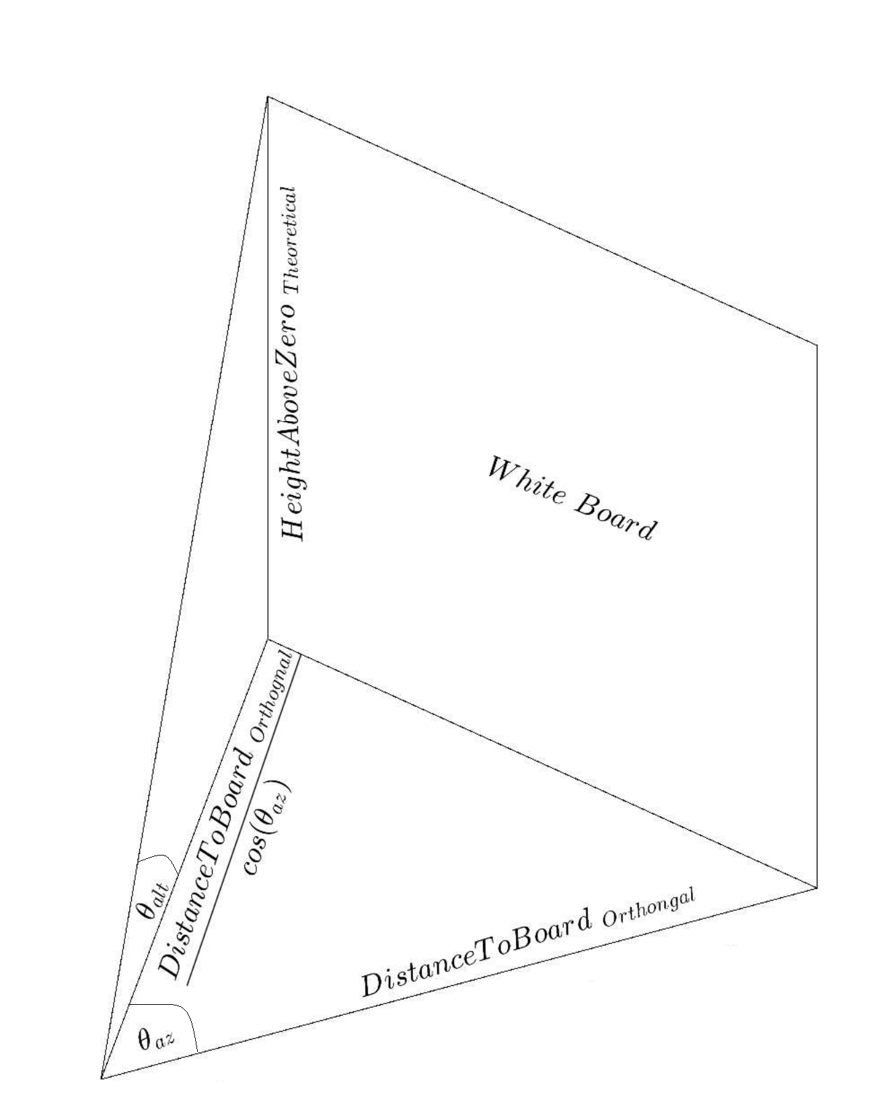
Images/Board Trig-1.png
