ssteejans/thesis/Images/IMG_20181118_151825.jpg

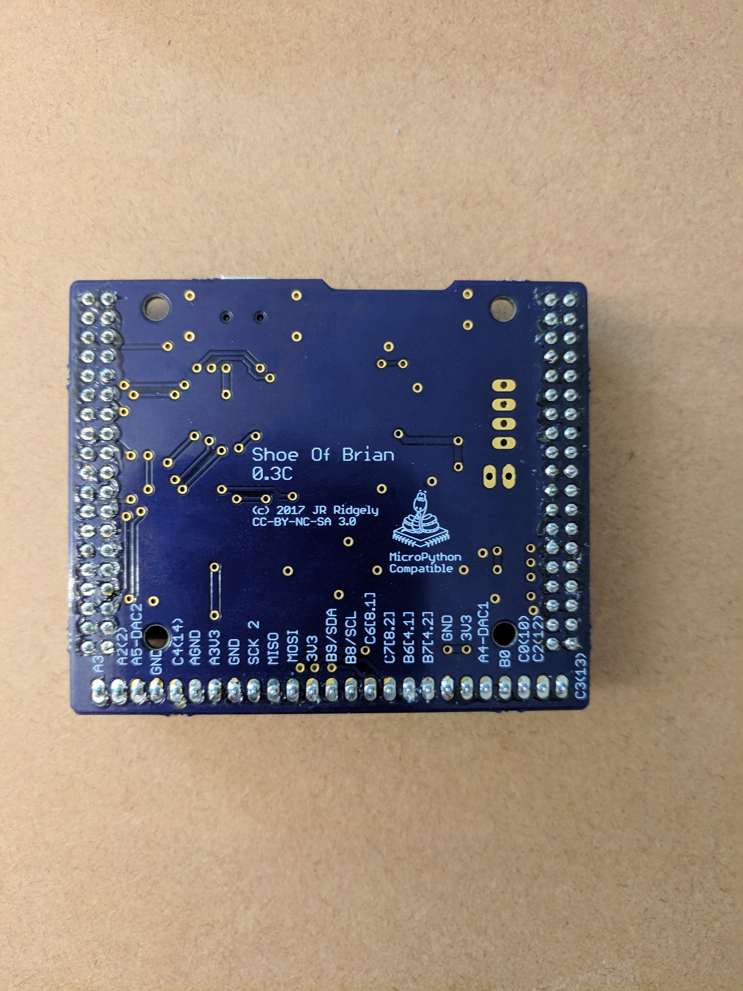
Images/IMG_20181118_151825.jpg
