ssteejans/thesis/Images/IMG_20190710_170255.jpg

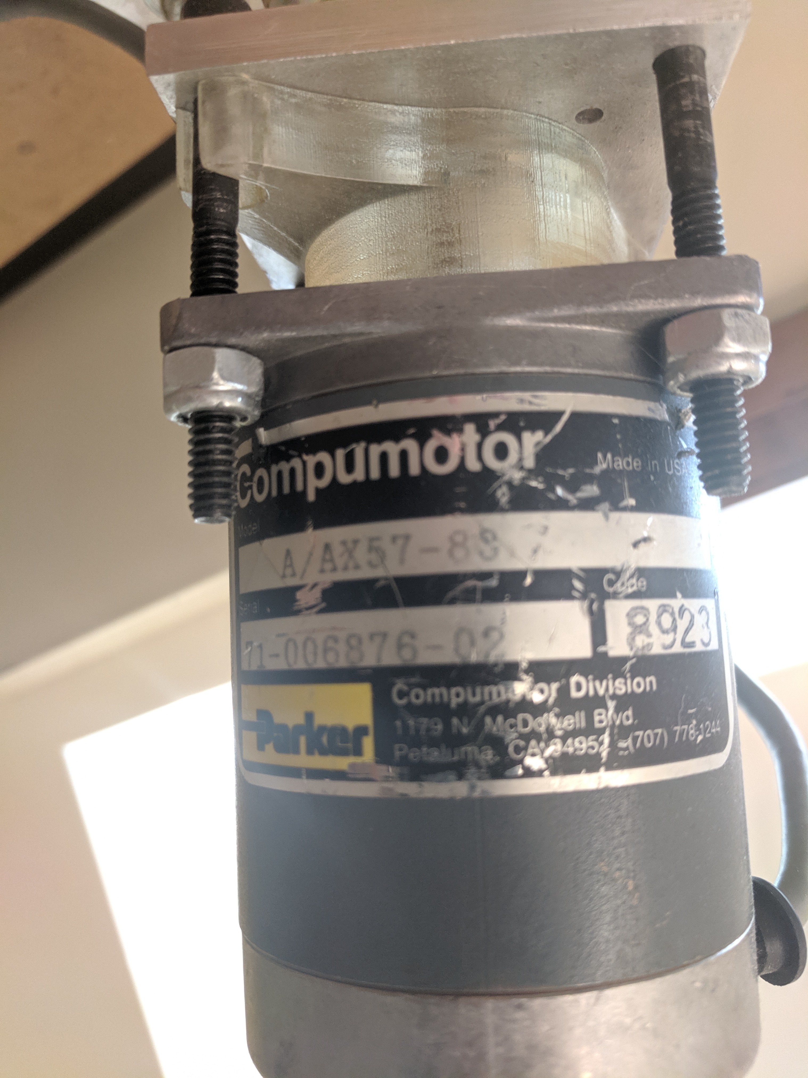
Images/IMG_20190710_170255.jpg
