ssteejans/thesis/Images/Linear Actuator.PNG

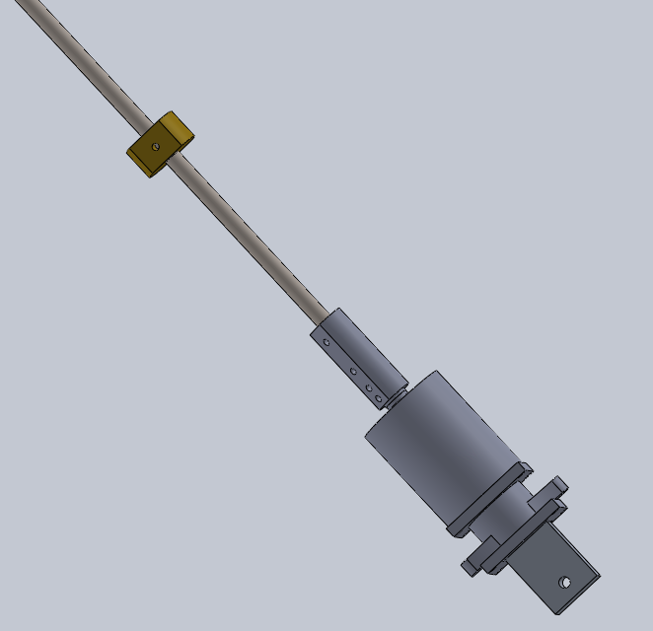
Images/Linear Actuator.PNG
