ssteejans/thesis/Images/OTA Frame.PNG

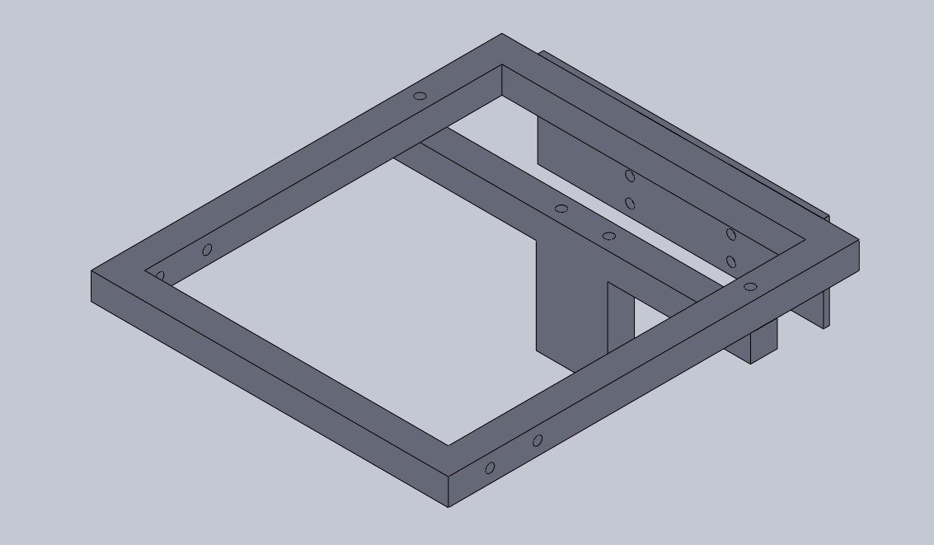
Images/OTA Frame.PNG
