ssteejans/thesis/Images/Point Definitions.PNG

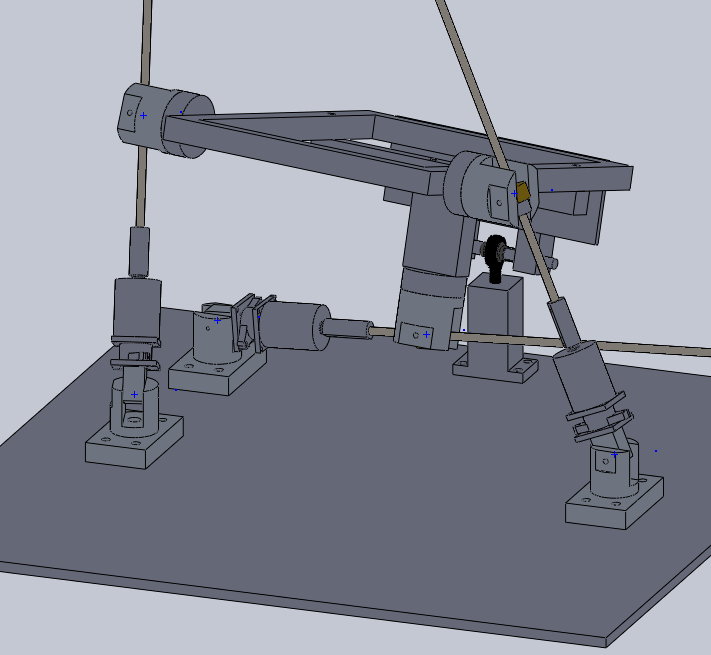
Images/Point Definitions.PNG
