ssteejans/thesis/Images/SampleBaseBearings.PNG

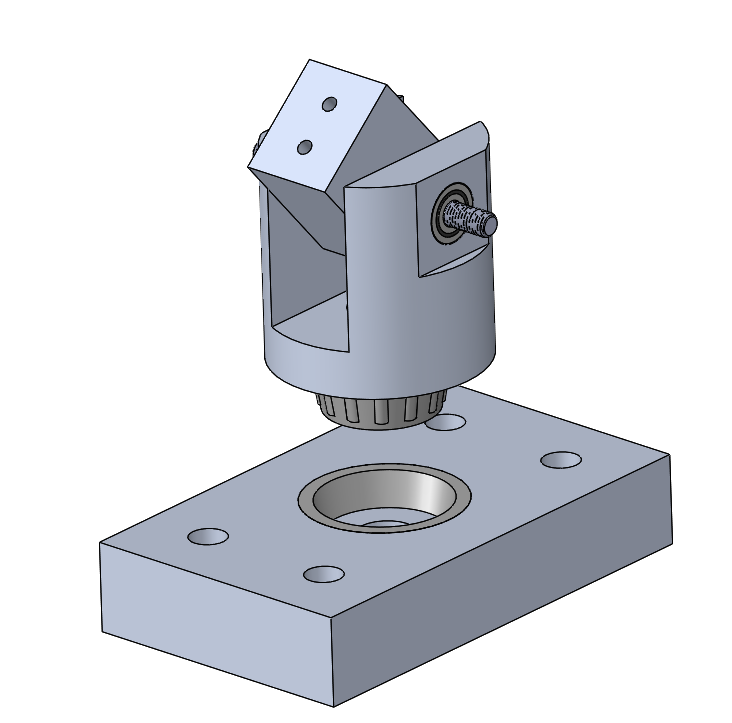
Images/SampleBaseBearings.PNG
