ssteejans/thesis/Images/SampleMotorBearing.PNG

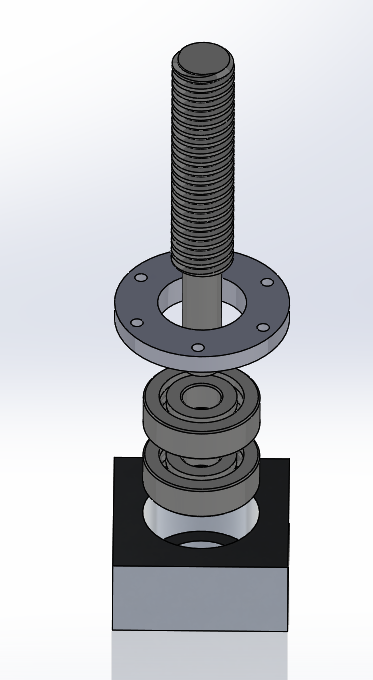
Images/SampleMotorBearing.PNG
