ssteejans/thesis/Images/theta-az,r-alt plot.PNG

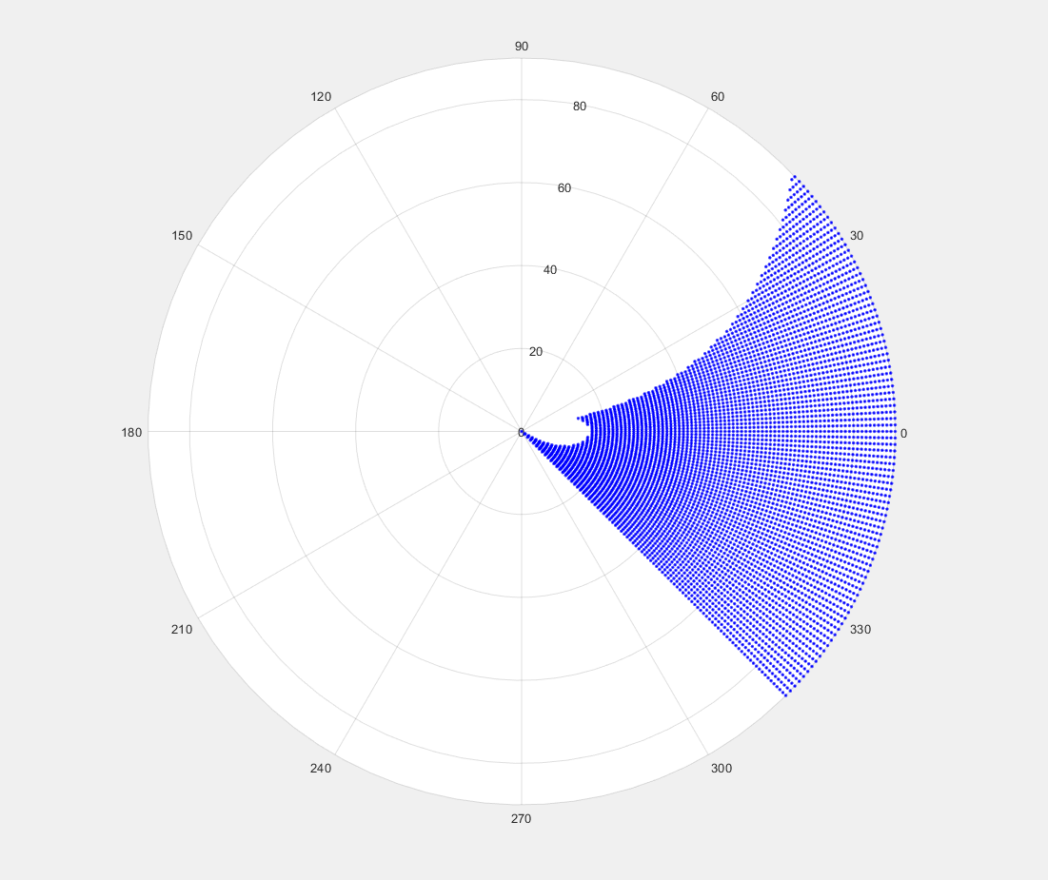
Images/theta-az,r-alt plot.PNG
