ssteejans/thesis/Matlab work/Plotting model onto surfaces/Intersection of Optical Axis with sphere.png

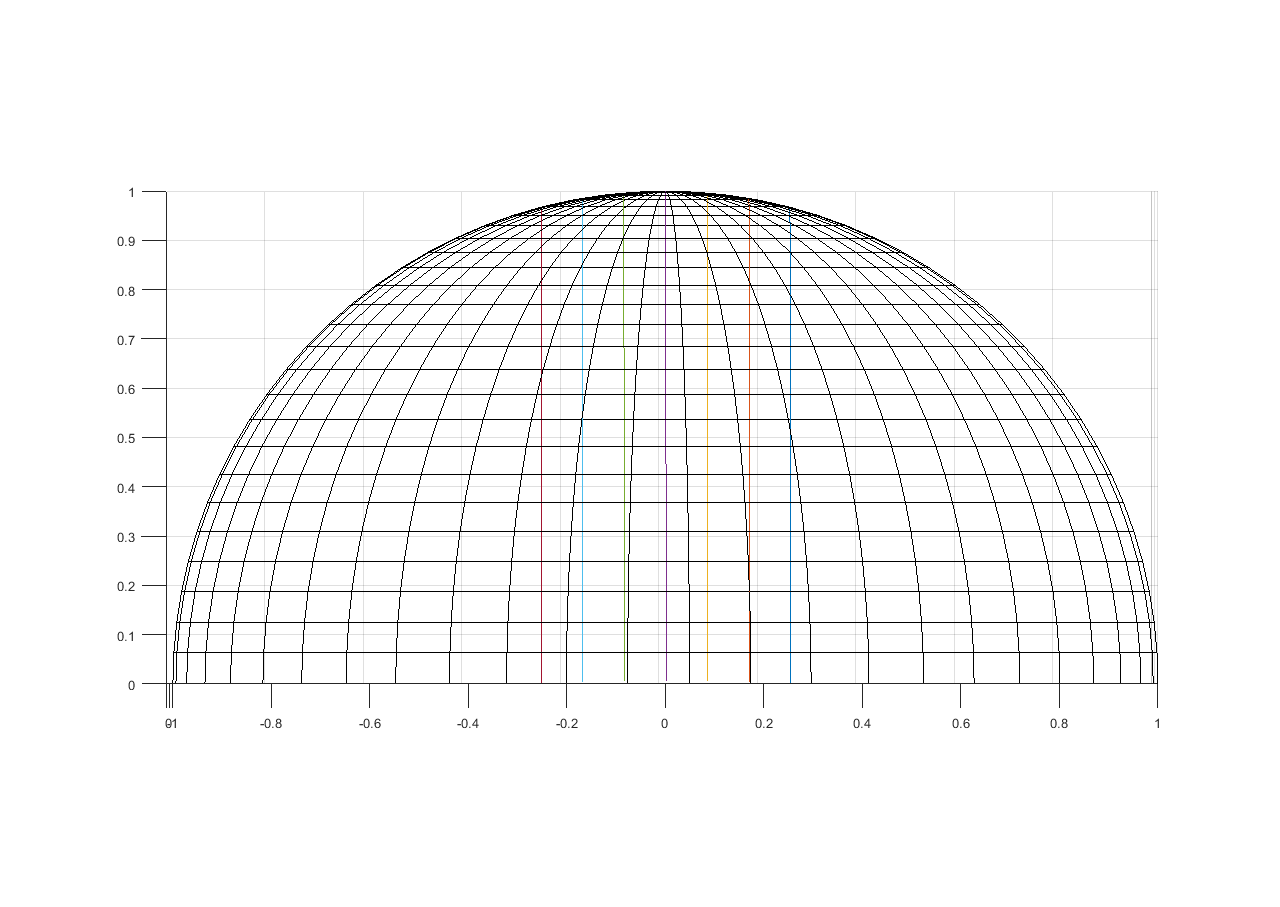
Matlab work/Plotting model onto surfaces/Intersection of Optical Axis with sphere.png
