ssteejans/thesis/Thesis Solidmodel/Frame Assembly.SLDASM

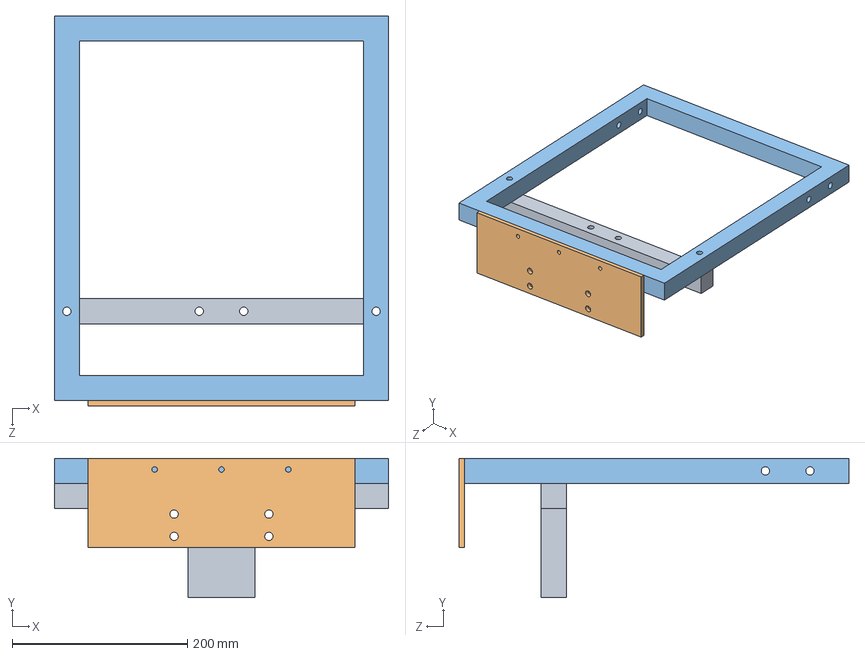
[picture p113: CAD file, 2019-07-11]
Thesis Solidmodel/Frame Assembly.SLDASM
381.0 x 158.8 x 444.5 mm
Dropdown
Backplate
8020Frame
