ssteejans/thesis/Thesis Solidmodel/AnglesDef.SLDASM

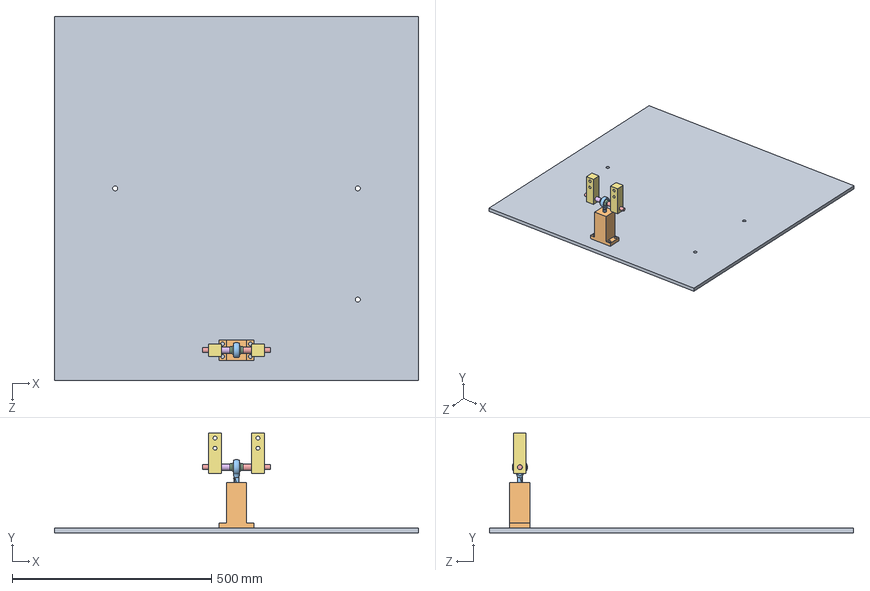
[picture p114: CAD file, 2018-11-22]
Thesis Solidmodel/AnglesDef.SLDASM
914.4 x 250.8 x 914.4 mm
Base
RotatorBaseMount
6960T110_Arm
6960T110_Ball
RotatorBaseArm
Spacer
RotatorBaseLeg x 2
