ssteejans/thesis/Thesis Solidmodel/Sample Motor bracket with bearings/Assem1.SLDASM

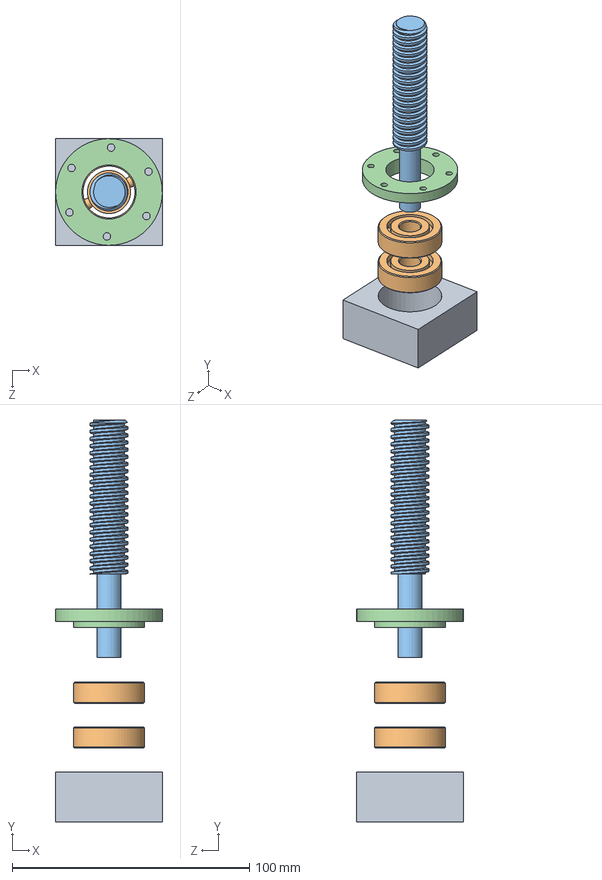
[picture p115: CAD file, 2020-06-30]
Thesis Solidmodel/Sample Motor bracket with bearings/Assem1.SLDASM
45.0 x 169.4 x 45.0 mm
bearing housing
6680K110_ANGULAR-CONTACT BALL BEARING x 2
7549K760_RIGHT-HAND PRECISION ACME LEAD SCREW
Bearing retainer
