ssteejans/thesis/Thesis Solidmodel/Motor Assembly.SLDASM

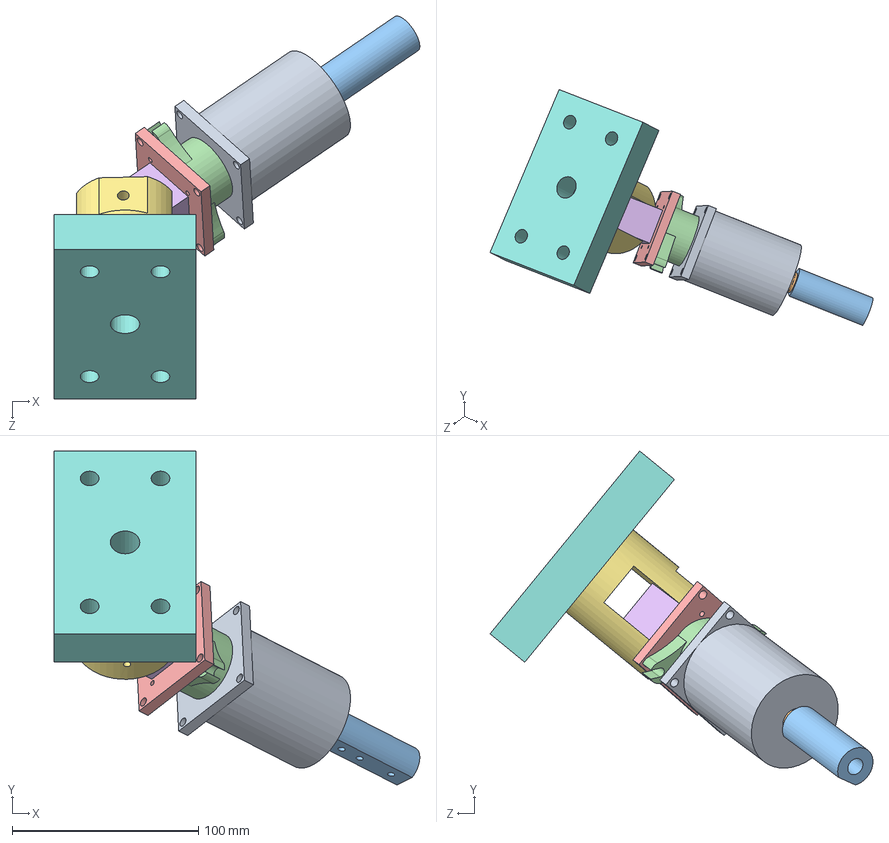
[picture p116: CAD file, 2018-11-17]
Thesis Solidmodel/Motor Assembly.SLDASM
196.5 x 179.5 x 205.9 mm
Motor
ThrustBearing
Coupler
MotorSpacer
Stepper Conversion Plate
MotorHinge
MotorRotator
MotorBasePlate
