ssteejans/thesis/Thesis Solidmodel/New folder/Assem1.SLDASM

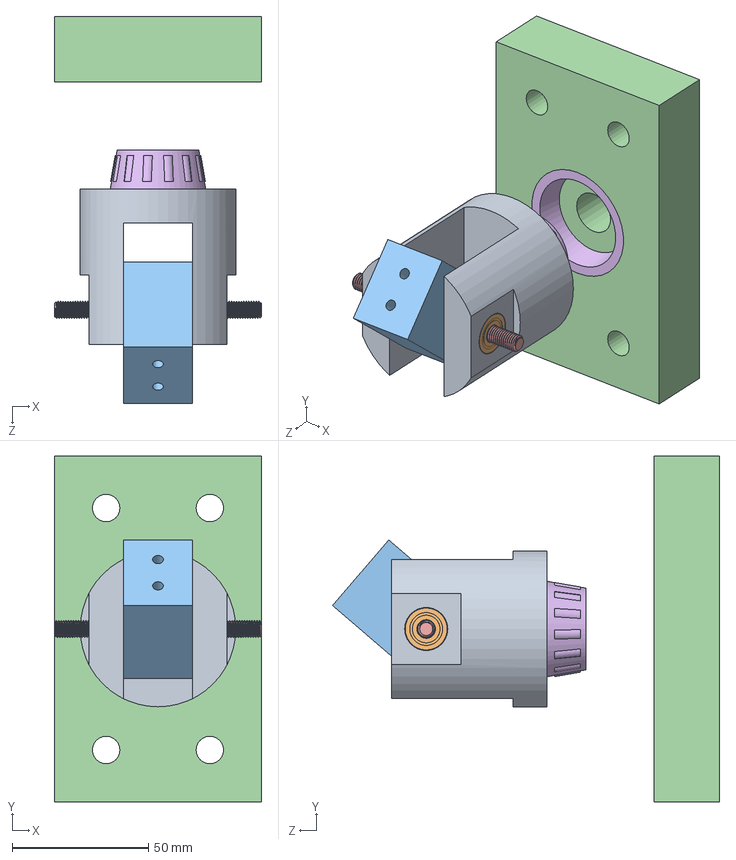
[picture p117: CAD file, 2020-07-02]
Thesis Solidmodel/New folder/Assem1.SLDASM
76.2 x 127.0 x 142.2 mm
MotorRotator
shaftBearing x 2
MotorHinge
MotorBasePlate
shaft
BaseBearing
