ssteejans/thesis/Thesis Solidmodel/FullAssembly.SLDASM

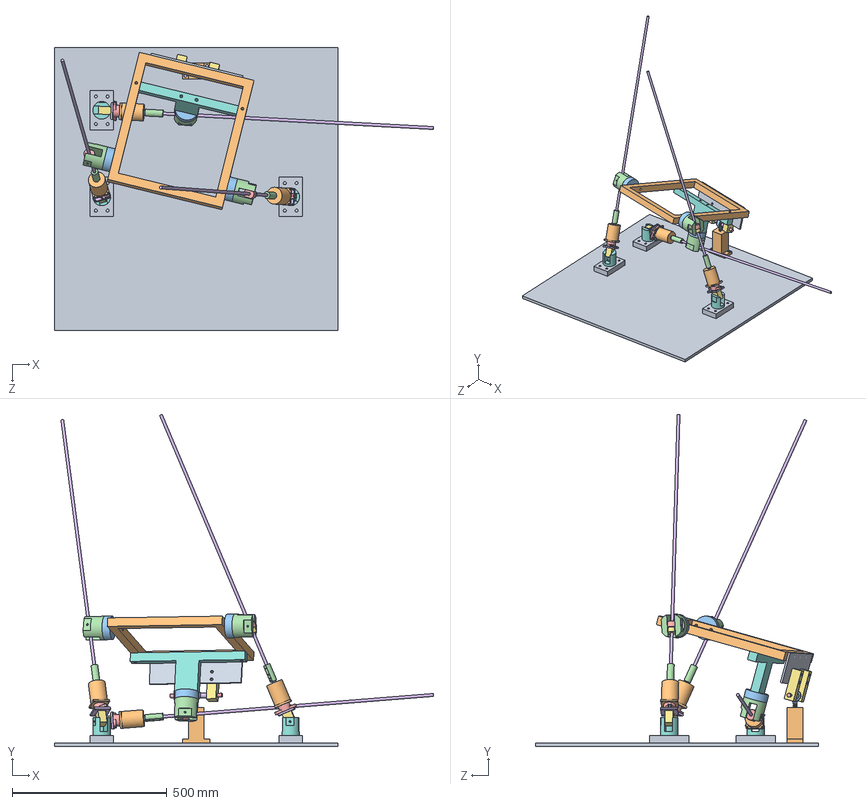
[picture p118: CAD file, 2018-11-17]
Thesis Solidmodel/FullAssembly.SLDASM
1222.8 x 1072.6 x 914.4 mm
Base
Motor x 3
ThrustBearing x 3
Coupler x 3
MotorSpacer x 3
Stepper Conversion Plate x 3
MotorHinge x 3
MotorRotator x 3
MotorBasePlate x 3
RotatorBaseMount
6960T110_Arm
6960T110_Ball
RotatorBaseArm
Spacer
RotatorBaseLeg x 2
Dropdown
Backplate
8020Frame
Support x 3
ActuatorRotator x 3
AcmeNut x 3
AcmeRod x 3
HardStop x 3
