ssteejans/thesis/Thesis Solidmodel/OTA Assembly.SLDASM

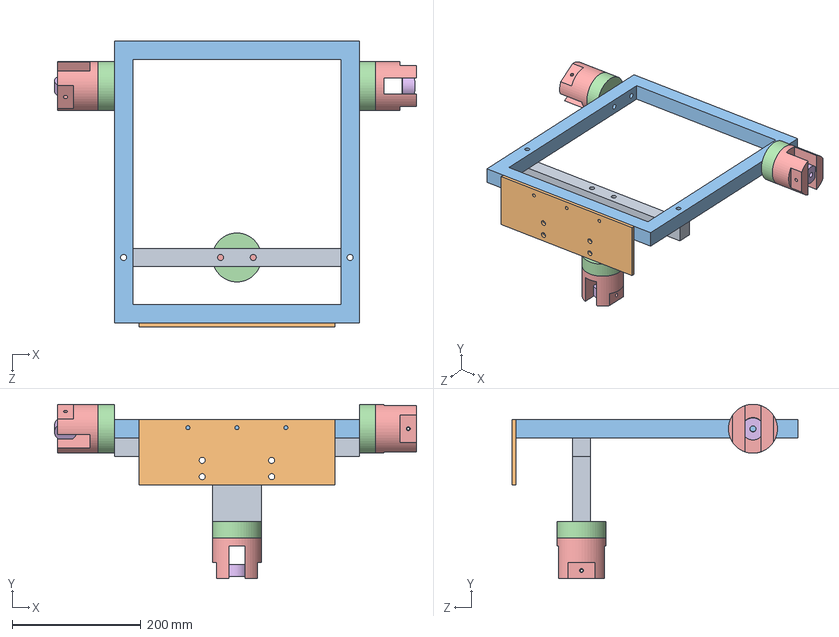
[picture p119: CAD file, 2018-11-17]
Thesis Solidmodel/OTA Assembly.SLDASM
563.2 x 271.5 x 444.5 mm
Dropdown
Backplate
8020Frame
Support x 3
ActuatorRotator x 3
AcmeNut x 3
