ssteejans/thesis/Thesis Solidmodel/BaseRotationAssembly.SLDASM

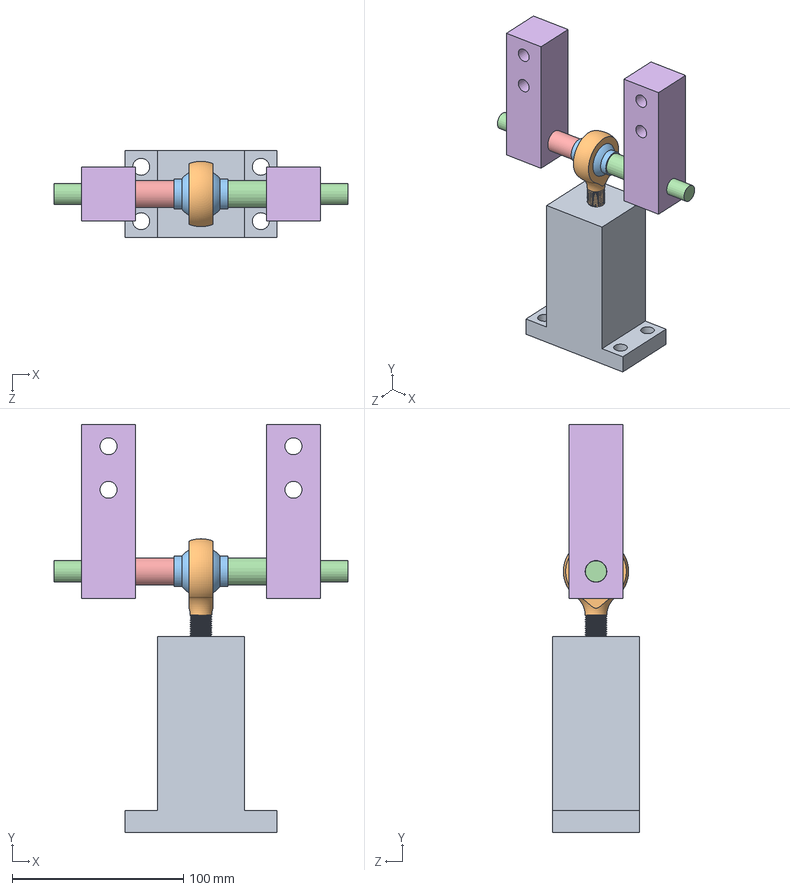
[picture p120: CAD file, 2018-11-17]
Thesis Solidmodel/BaseRotationAssembly.SLDASM
171.4 x 238.1 x 50.8 mm
RotatorBaseMount
6960T110_Arm
6960T110_Ball
RotatorBaseArm
Spacer
RotatorBaseLeg x 2
