ssteejans/thesis/Thesis Solidmodel/New folder/shaftBearing.SLDPRT

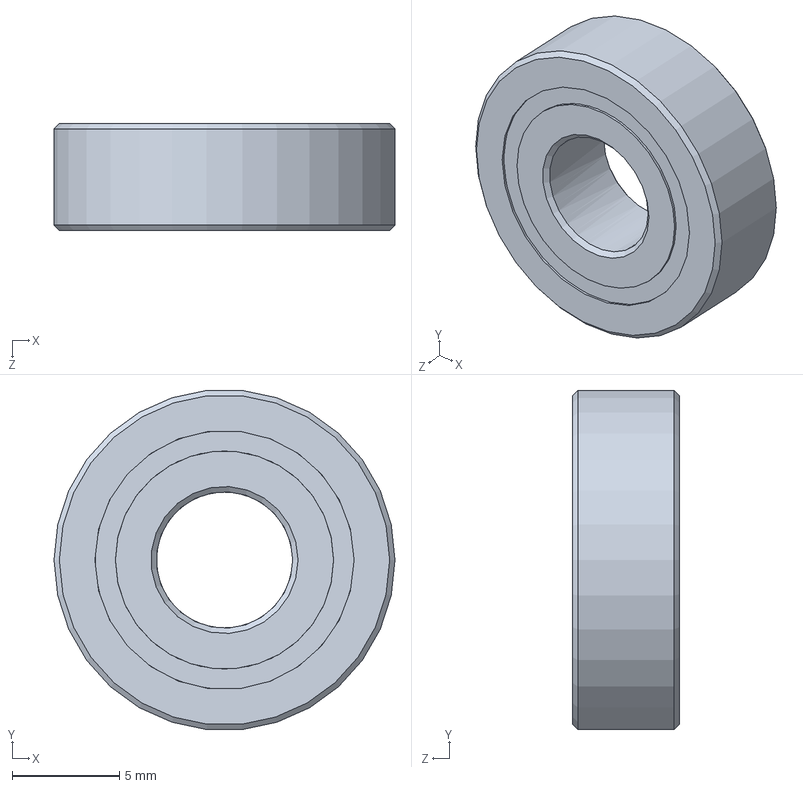
[picture p121: CAD file, 2020-07-02]
Thesis Solidmodel/New folder/shaftBearing.SLDPRT
15.9 x 15.8 x 4.98 mm
