ssteejans/thesis/Thesis Solidmodel/New folder/BaseBearing.SLDPRT

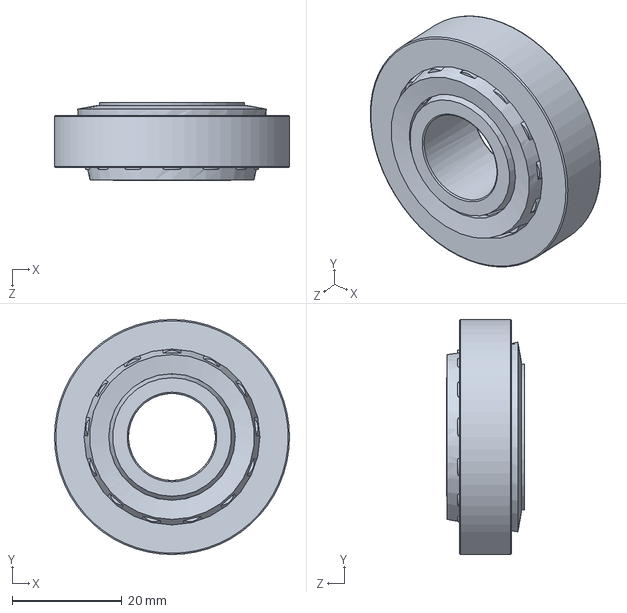
[picture p122: CAD file, 2020-07-02]
Thesis Solidmodel/New folder/BaseBearing.SLDPRT
42.9 x 42.9 x 14.3 mm
