ssteejans/thesis/Thesis Solidmodel/Sample Motor bracket with bearings/Bearing retainer.SLDPRT

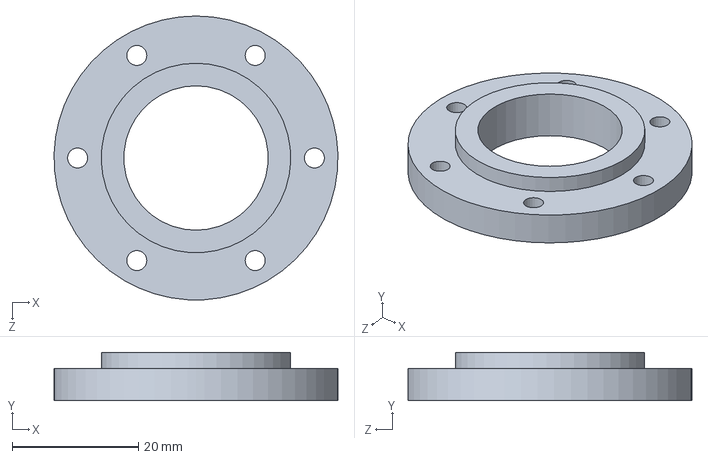
[picture p123: CAD file, 2020-06-30]
Thesis Solidmodel/Sample Motor bracket with bearings/Bearing retainer.SLDPRT
44.9 x 7.62 x 45.0 mm
