ssteejans/thesis/Thesis Solidmodel/Backplate.SLDPRT

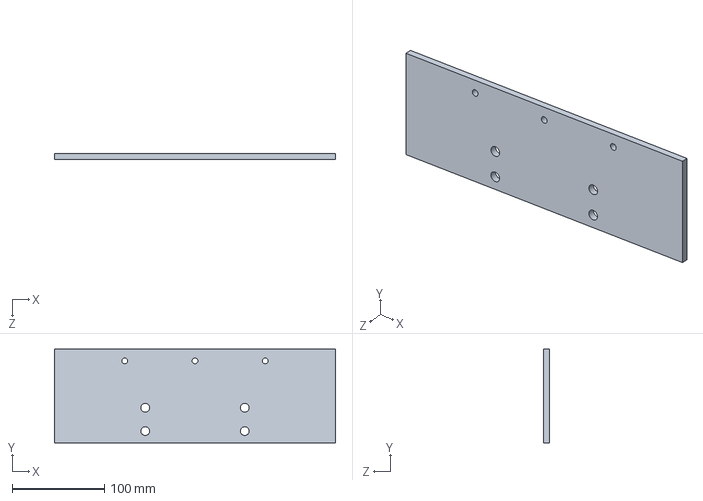
[picture p124: CAD file, 2018-11-17]
Thesis Solidmodel/Backplate.SLDPRT
304.8 x 101.6 x 6.35 mm
