ssteejans/thesis/Thesis Solidmodel/New folder/MotorBasePlate.SLDPRT

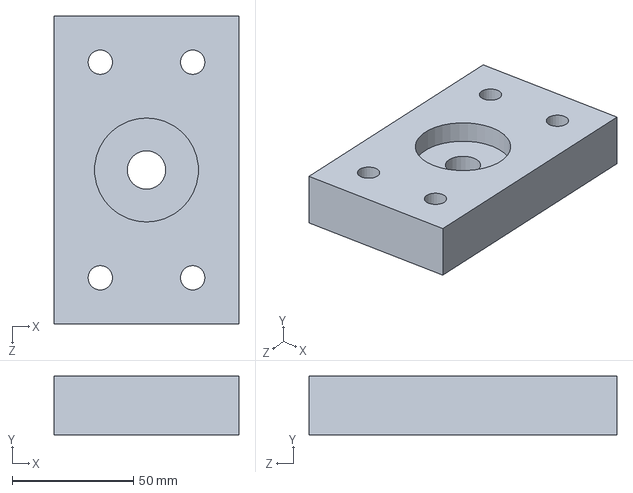
[picture p125: CAD file, 2020-07-02]
Thesis Solidmodel/New folder/MotorBasePlate.SLDPRT
76.2 x 24.1 x 127.0 mm
