ssteejans/thesis/Thesis Solidmodel/AcmeRod.SLDPRT

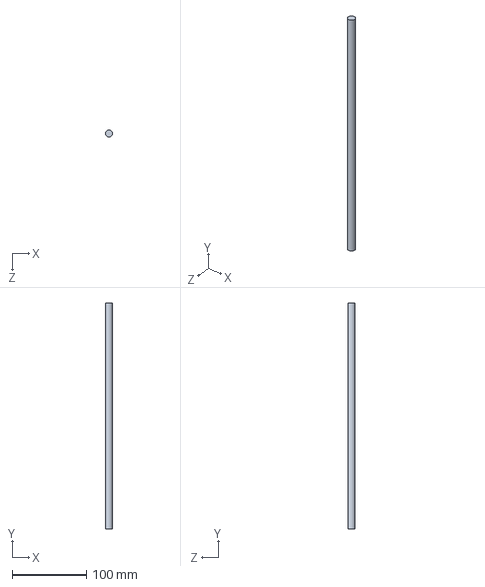
[picture p126: CAD file, 2018-11-17]
Thesis Solidmodel/AcmeRod.SLDPRT
9.53 x 304.8 x 9.53 mm
