ssteejans/thesis/Thesis Solidmodel/New folder/MotorHinge.SLDPRT

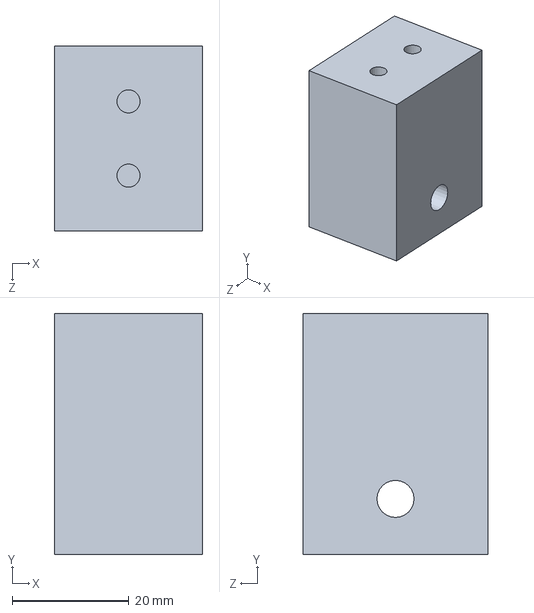
[picture p127: CAD file, 2020-07-02]
Thesis Solidmodel/New folder/MotorHinge.SLDPRT
25.4 x 41.3 x 31.8 mm
