ssteejans/thesis/Thesis Solidmodel/Sample Motor bracket with bearings/bearing housing.SLDPRT

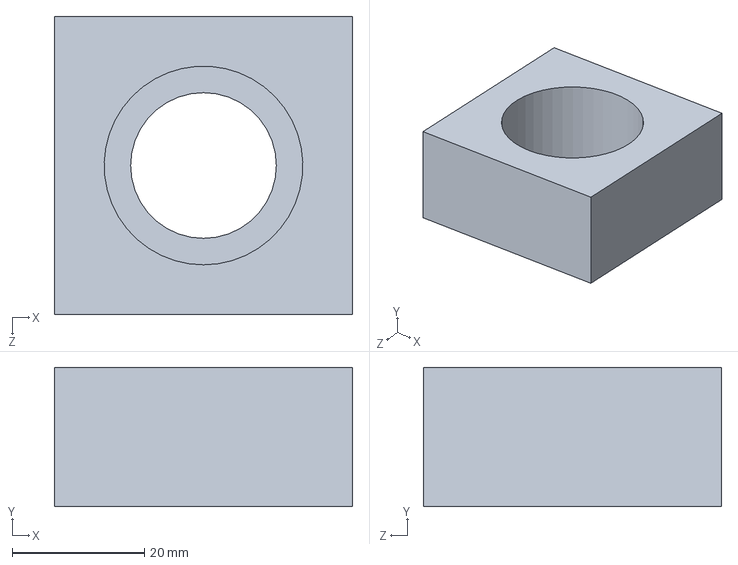
[picture p128: CAD file, 2020-06-30]
Thesis Solidmodel/Sample Motor bracket with bearings/bearing housing.SLDPRT
45.0 x 21.0 x 45.0 mm
