ssteejans/thesis/Thesis Solidmodel/MotorRotator.SLDPRT

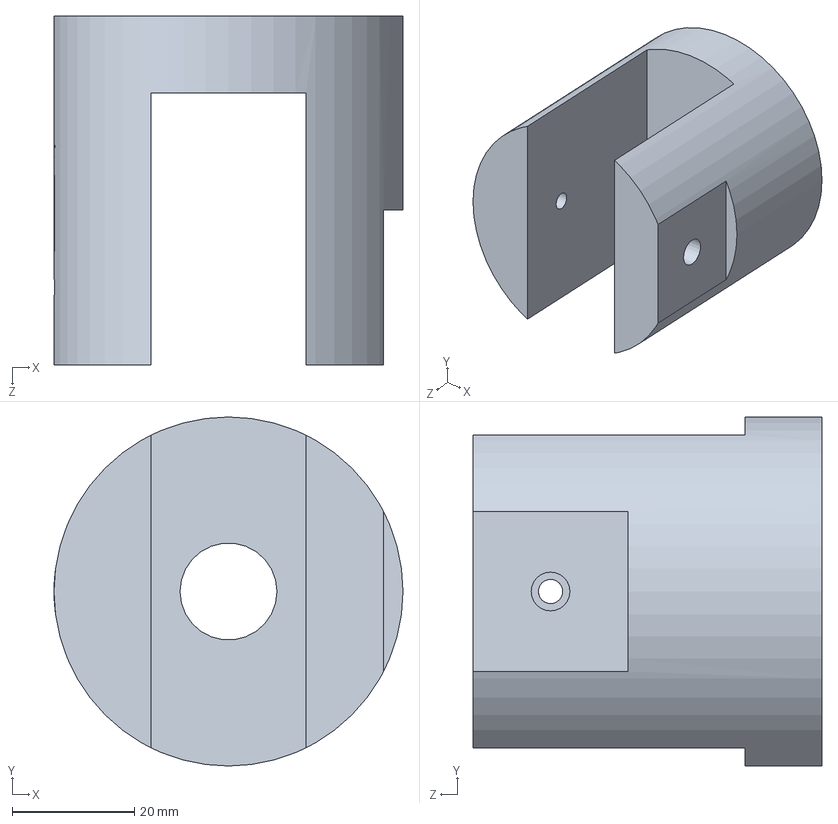
[picture p129: CAD file, 2018-11-17]
Thesis Solidmodel/MotorRotator.SLDPRT
57.1 x 57.1 x 57.1 mm
