ssteejans/thesis/Thesis Solidmodel/New folder/shaft.SLDPRT

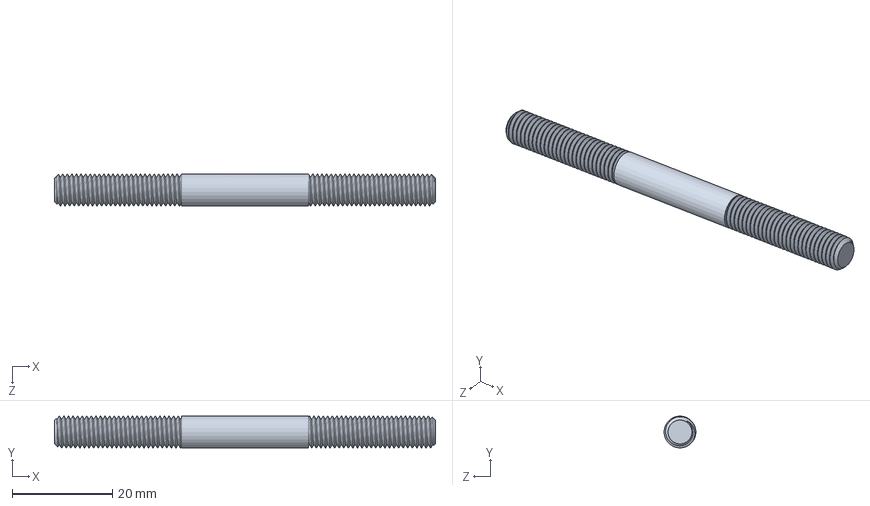
[picture p130: CAD file, 2020-07-02]
Thesis Solidmodel/New folder/shaft.SLDPRT
76.2 x 6.35 x 6.35 mm
