ssteejans/thesis/Thesis Solidmodel/Coupler.SLDPRT

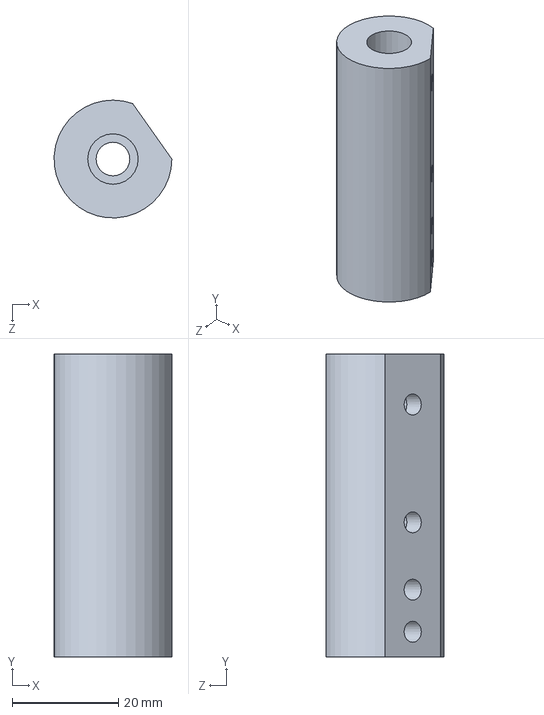
[picture p131: CAD file, 2018-11-17]
Thesis Solidmodel/Coupler.SLDPRT
22.2 x 57.1 x 22.2 mm
