ssteejans/thesis/Thesis Solidmodel/RotatorBaseLeg.SLDPRT

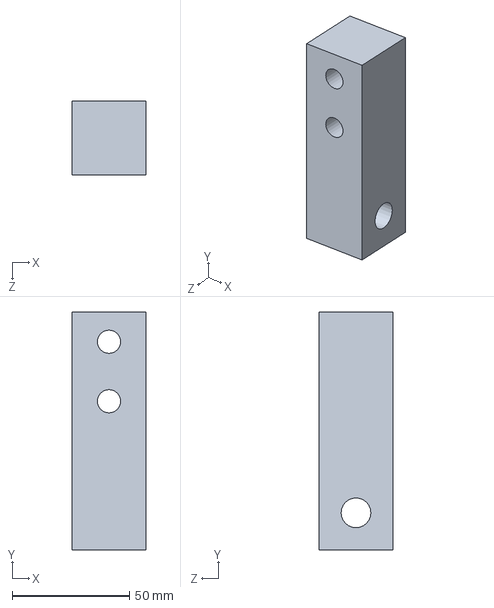
[picture p132: CAD file, 2018-11-17]
Thesis Solidmodel/RotatorBaseLeg.SLDPRT
31.8 x 101.6 x 31.8 mm
