ssteejans/thesis/Thesis Solidmodel/AcmeNut.SLDPRT

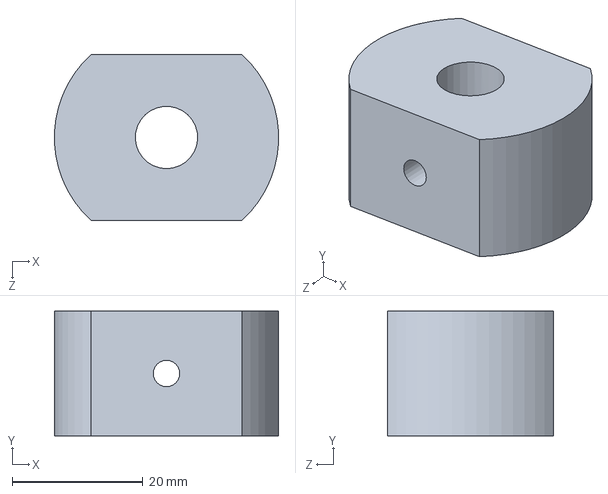
[picture p133: CAD file, 2018-11-17]
Thesis Solidmodel/AcmeNut.SLDPRT
34.2 x 19.1 x 25.4 mm
