ssteejans/thesis/Thesis Solidmodel/HardStop.SLDPRT

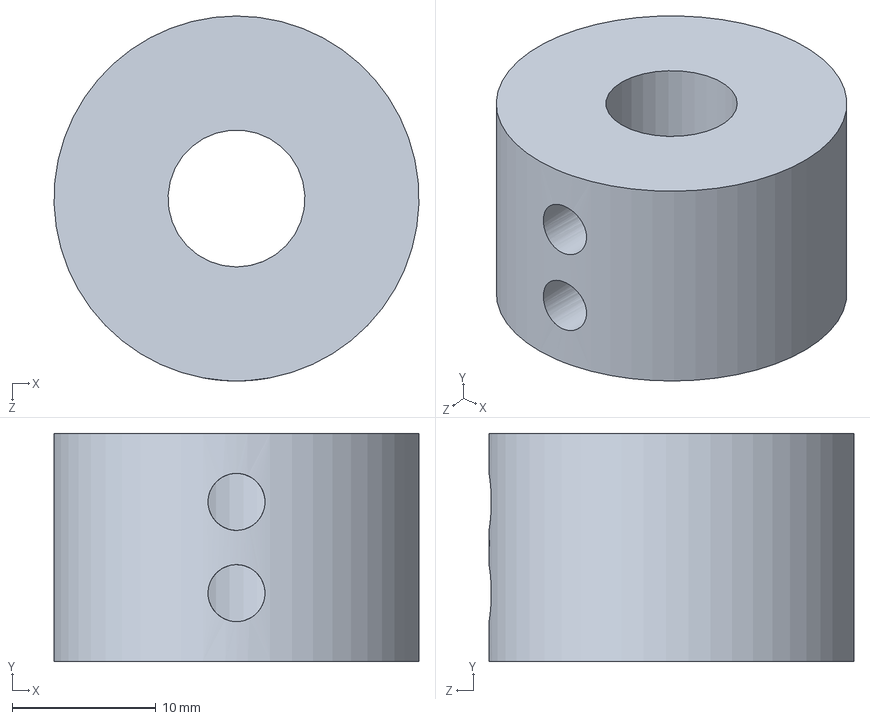
[picture p134: CAD file, 2018-11-17]
Thesis Solidmodel/HardStop.SLDPRT
25.4 x 15.9 x 25.4 mm
