ssteejans/thesis/Thesis Solidmodel/Support.SLDPRT

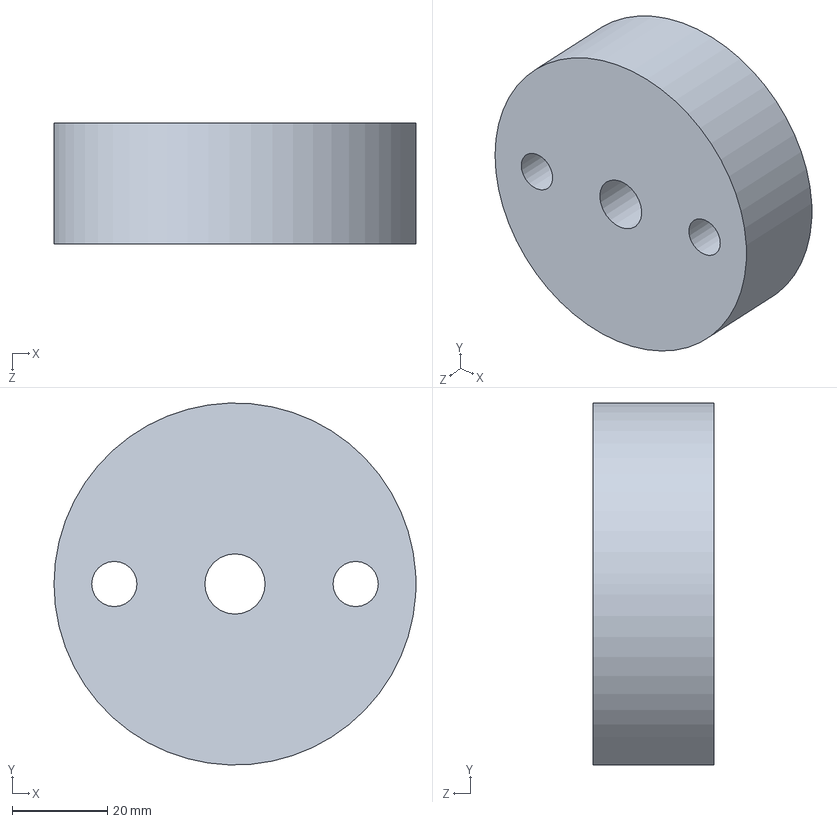
[picture p135: CAD file, 2018-11-17]
Thesis Solidmodel/Support.SLDPRT
76.2 x 76.2 x 25.4 mm
