ssteejans/thesis/Thesis Solidmodel/MotorSpacer.SLDPRT

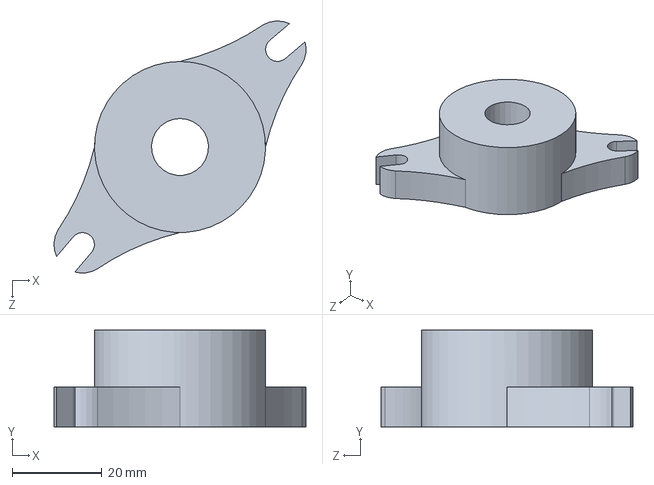
[picture p136: CAD file, 2018-11-17]
Thesis Solidmodel/MotorSpacer.SLDPRT
56.1 x 21.6 x 56.1 mm
