ssteejans/thesis/Thesis Solidmodel/Motor.SLDPRT

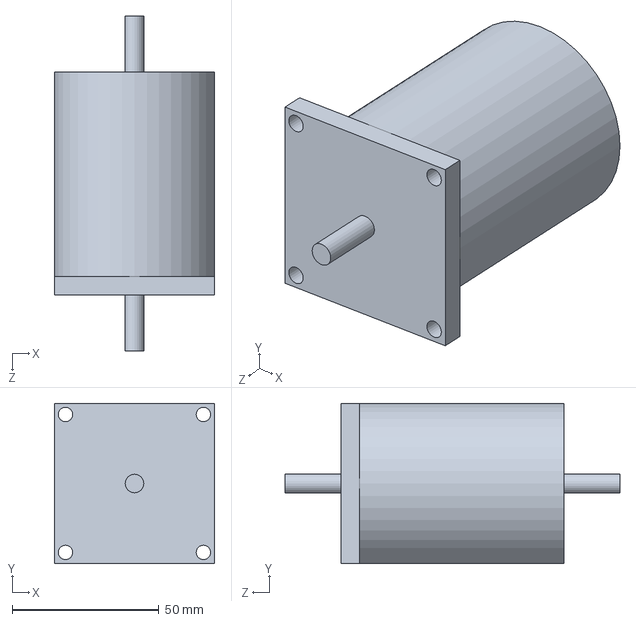
[picture p137: CAD file, 2018-11-17]
Thesis Solidmodel/Motor.SLDPRT
54.6 x 54.6 x 114.3 mm
