ssteejans/thesis/Thesis Solidmodel/8020Frame.SLDPRT

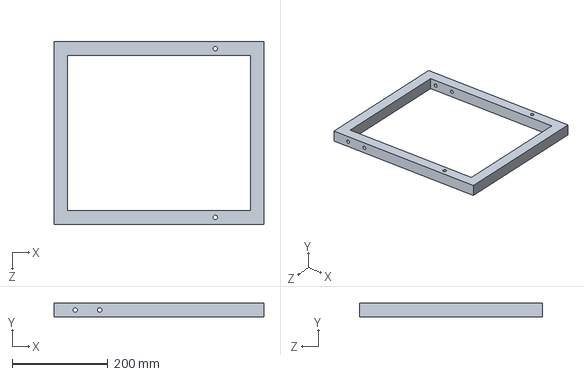
[picture p138: CAD file, 2018-11-17]
Thesis Solidmodel/8020Frame.SLDPRT
438.1 x 28.6 x 381.0 mm
