ssteejans/thesis/Thesis Solidmodel/Base.SLDPRT

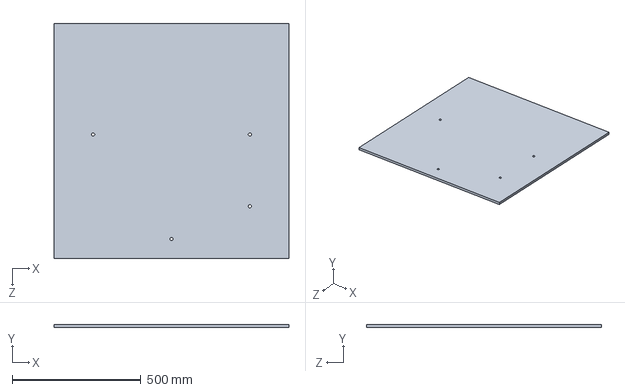
[picture p139: CAD file, 2018-11-17]
Thesis Solidmodel/Base.SLDPRT
914.4 x 12.7 x 914.4 mm
