ssteejans/thesis/Thesis Solidmodel/Spacer.SLDPRT

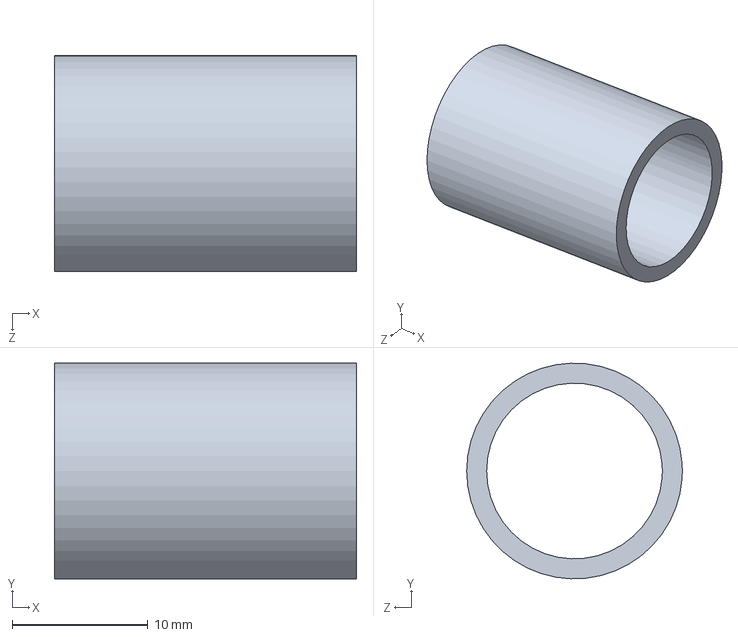
[picture p140: CAD file, 2018-11-17]
Thesis Solidmodel/Spacer.SLDPRT
22.2 x 15.9 x 15.9 mm
