ssteejans/thesis/Thesis Solidmodel/RotatorBaseArm.SLDPRT

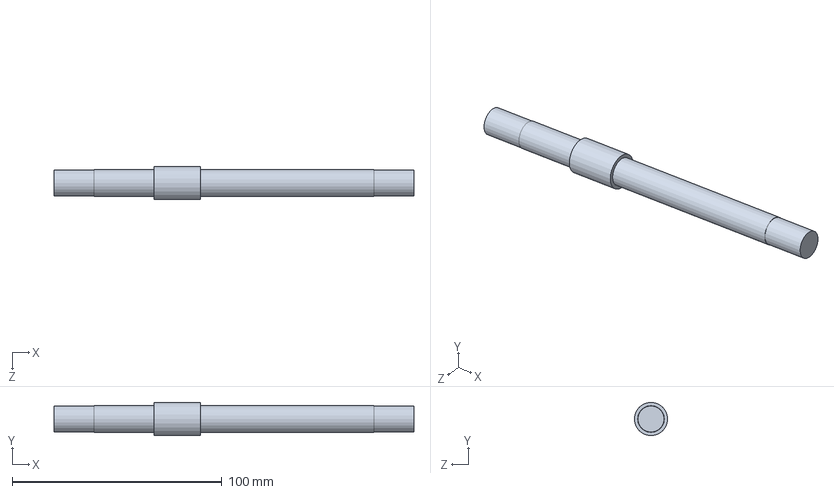
[picture p141: CAD file, 2018-11-17]
Thesis Solidmodel/RotatorBaseArm.SLDPRT
171.4 x 15.9 x 15.9 mm
