ssteejans/thesis/Thesis Solidmodel/ThrustBearing.SLDPRT

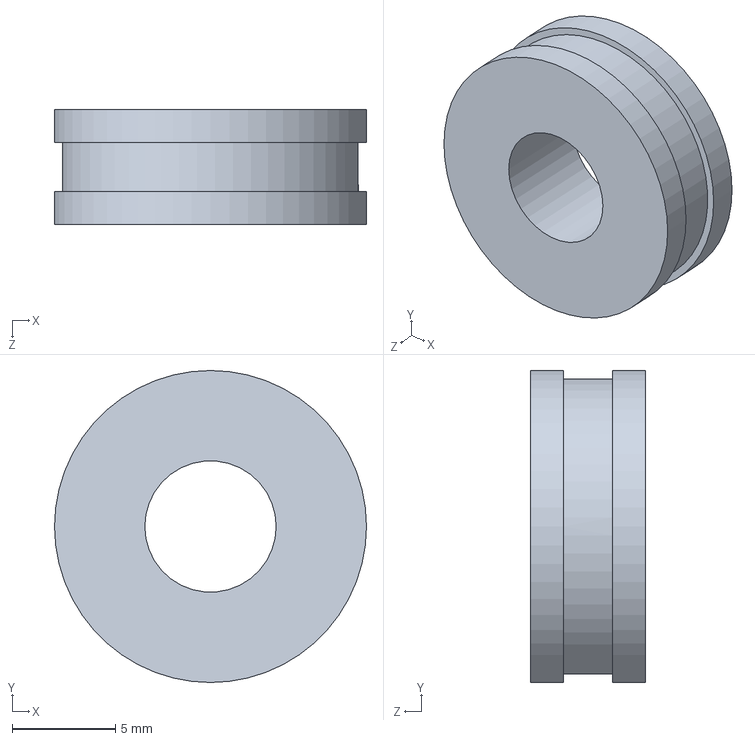
[picture p142: CAD file, 2018-11-17]
Thesis Solidmodel/ThrustBearing.SLDPRT
15.1 x 15.1 x 5.56 mm
