ssteejans/thesis/Thesis Solidmodel/RotatorBaseMount.SLDPRT

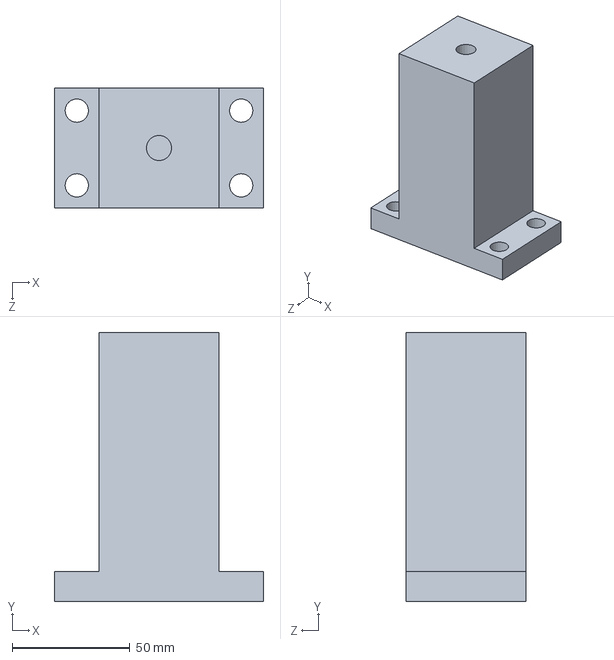
[picture p143: CAD file, 2018-11-17]
Thesis Solidmodel/RotatorBaseMount.SLDPRT
88.9 x 114.3 x 50.8 mm
