ssteejans/thesis/Thesis Solidmodel/Stepper Conversion Plate.SLDPRT

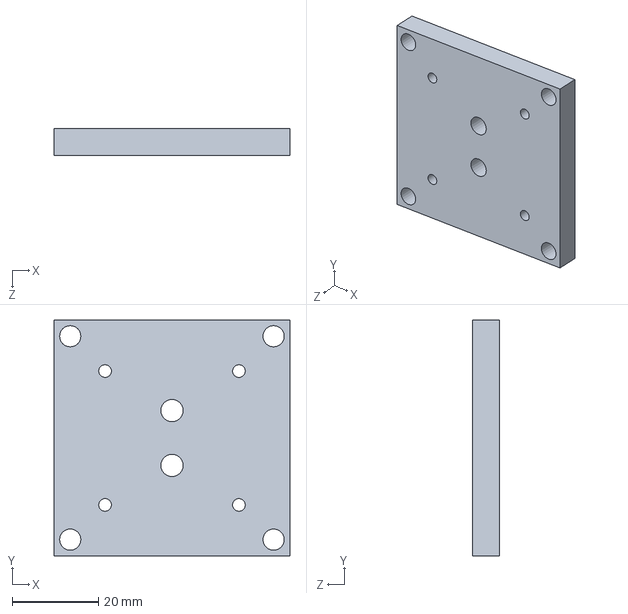
[picture p144: CAD file, 2018-11-17]
Thesis Solidmodel/Stepper Conversion Plate.SLDPRT
54.6 x 54.6 x 6.35 mm
