ssteejans/thesis/Thesis Solidmodel/ActuatorRotator.SLDPRT

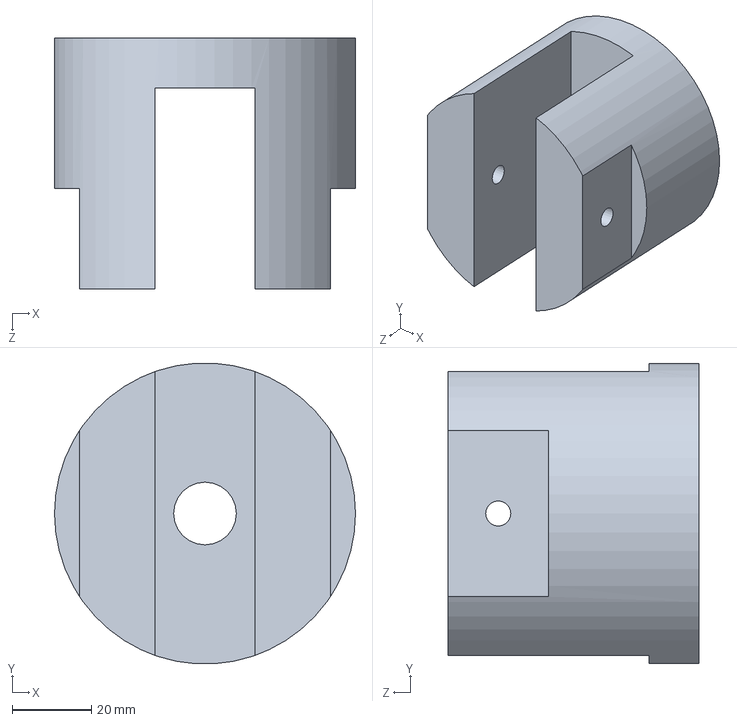
[picture p145: CAD file, 2018-11-17]
Thesis Solidmodel/ActuatorRotator.SLDPRT
76.2 x 76.0 x 63.5 mm
