ssteejans/thesis/Thesis Solidmodel/MotorBasePlate.SLDPRT

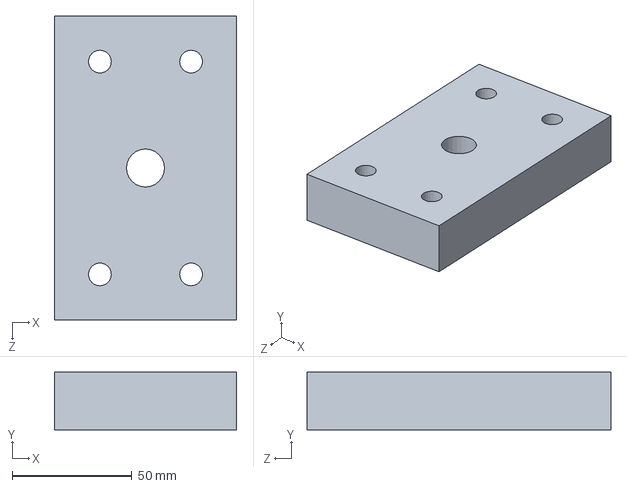
[picture p146: CAD file, 2018-11-17]
Thesis Solidmodel/MotorBasePlate.SLDPRT
76.2 x 24.1 x 127.0 mm
