ssteejans/thesis/Thesis Solidmodel/Dropdown.SLDPRT

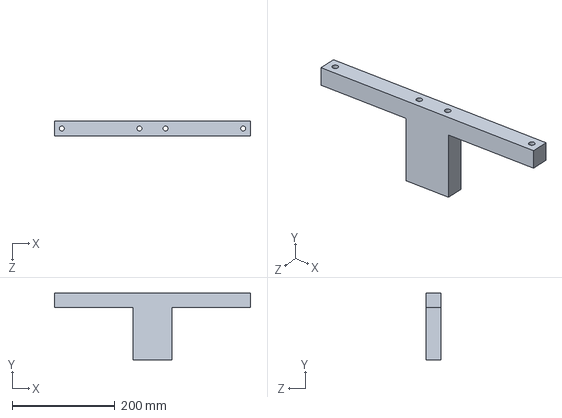
[picture p147: CAD file, 2018-11-17]
Thesis Solidmodel/Dropdown.SLDPRT
381.0 x 130.2 x 28.6 mm
