ssteejans/thesis/(list of files, cad)

Other CAD files:
Thesis Solidmodel/New folder/MotorRotator.SLDPRT
Thesis Solidmodel/MotorHinge.SLDPRT
Thesis Solidmodel/6960T110.SLDASM
Thesis Solidmodel/6960T110_Arm.SLDPRT
Thesis Solidmodel/6960T110_Ball.SLDPRT
Thesis Solidmodel/8020Frame.SLDDRW
Thesis Solidmodel/Backplate.SLDDRW
Thesis Solidmodel/Dropdown.SLDDRW
Thesis Solidmodel/Frame Assembly.SLDDRW
Thesis Solidmodel/MotorSpacer.SLDDRW
Thesis Solidmodel/Sample Motor bracket with bearings/6680K110_ANGULAR-CONTACT BALL BEARING.SLDPRT
Thesis Solidmodel/Sample Motor bracket with bearings/7549K760_RIGHT-HAND PRECISION ACME LEAD SCREW.SLDPRT
Thesis Solidmodel/Stepper Conversion Plate.SLDDRW
