ssteejans/thesis/Images/Home Position Assembly.pdf

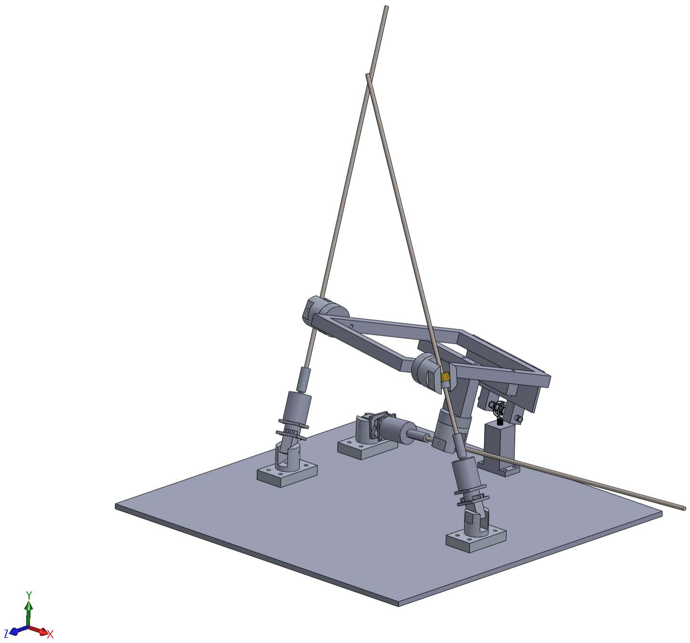
[picture p148: page 1]
