ssteejans/thesis/Images/Ball Joint Assembly.PNG

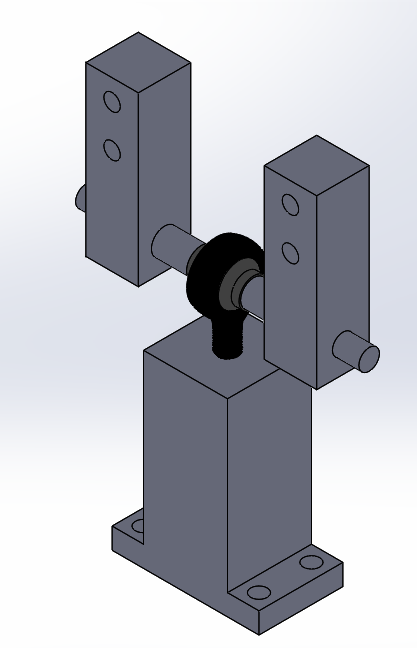
Images/Ball Joint Assembly.PNG
