ssteejans/thesis/Images/Baseplate with baserotationassembly.PNG

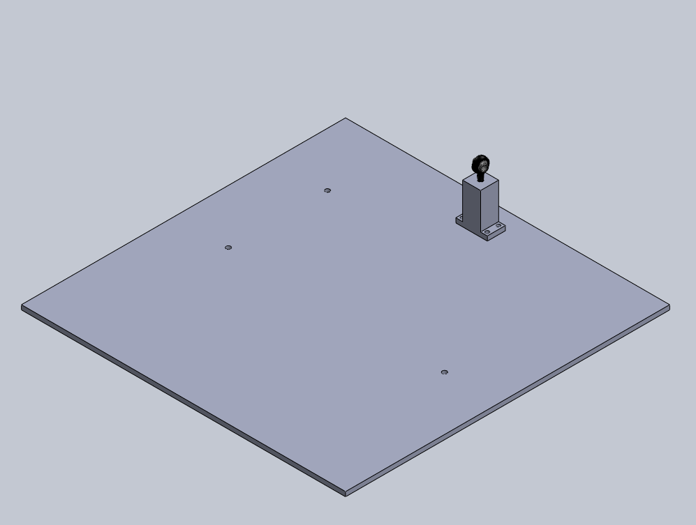
Images/Baseplate with baserotationassembly.PNG
