ssteejans/thesis/Testing/Velocity/Velocity Test/Velocity Tests.xlsx

 | Command Velocity [rad/s] | Starting Position [rad] | Ending Position [rad] | Time to Completion [s] | Calculated Velocity [rad/s] | % Error
Altitude 1 | 0.001 | 0.29 | 0.6 | 317.58 | 0.0009761319982 | 2.39
Altitude 2 | 0.002 | 0.29 | 0.6 | 161.162 | 0.001923530361 | 3.82
Azimuth 1 | 0.004 | -0.2 | 0.2 | 104.852 | 0.003814901003 | 4.63
Azimuth 2 | 0.006 | -0.2 | 0.2 | 69.564 | 0.005750100627 | 4.16
