ssteejans/thesis/Testing/Velocity/Azimuth Velocity/Azimuth Velocity Calcs.xlsx

 | Altitude | Azimuth | Rotation
Point 1 | 0.4 | 0.25 | 0
Point 2 | 0.4 | -0.25 | 0
CmdVelocity | 0 | -0.004 | 0
Length of Move (s) | 130
Calculated Velocity | 0 | -0.003846153846 | 0
% Error |  | 3.85%
