ssteejans/thesis/Testing/Image Rotation Angle Test/Result.txt

All images are of same test. Several photos were taken.
IMG_7861
Commanded to -0.1rad, 0rad, 0.1rad
corrected negative line is   -0.0908
corrected positive line is    0.1036
