ssteejans/thesis/Testing/Repeatability/Complex Repeatability/Test Reference.docx

Test 2 Ref Points

(Blue)

Alt, Az, Rot

P1: 0.3, 0, 0

P2: 0.3, 0.1, 0

P3: 0.4, 0.2, 0

P4: 0.4, -0.2, 0

P5: 0.6, -0.1, 0

P6: 0.5, 0.1, 0

Test 2A (Red)

Go from point 6 to each other point, returning to 6 in between

Test 2B (Orange)

Go from point 2 to each other point, returning to 2 in between

Test 2C (Green)

P6->P5->P4->P3->P2->P1->P6
