ssteejans/thesis/Testing/Grid of Points/Data From Matlab on img_7849.xlsx

Sheet: PairedCoord
azCmd | altCmd | x1 | y1 | x2 | y2 | xavg | yavg | xTheor | yTheor | Distance from 1 to 2 | x1 calc az | y1 calc alt | x2 calc az | y2 calc alt | xavg calc alt | yavg calc az | Az Error [deg] | Alt Error [deg]
-10 | 35 | -12.01 | 36.18 | -10.57 | 36.57 | -11.29 | 36.38 | -8.78 | 35.41 | 1.49 | -13.56 | 35.23 | -11.99 | 35.69 | -12.78 | 35.46 | 1.58 | 0.46
-10 | 30 | -11.11 | 29.55 | -10.21 | 29.79 | -10.66 | 29.67 | -8.78 | 29.20 | 0.93 | -12.57 | 30.08 | -11.59 | 30.36 | -12.08 | 30.22 | 0.98 | 0.29
-10 | 25 | -10.46 | 23.57 | -9.88 | 23.72 | -10.17 | 23.64 | -8.78 | 23.58 | 0.60 | -11.86 | 24.85 | -11.22 | 25.04 | -11.54 | 24.95 | 0.64 | 0.19
-10 | 20 | -9.92 | 18.15 | -9.23 | 18.37 | -9.58 | 18.26 | -8.78 | 18.41 | 0.72 | -11.27 | 19.67 | -10.50 | 19.93 | -10.89 | 19.80 | 0.77 | 0.26
-10 | 17 | -9.79 | 15.10 | -9.17 | 15.29 | -9.48 | 15.20 | -8.78 | 15.46 | 0.65 | -11.12 | 16.57 | -10.43 | 16.80 | -10.78 | 16.69 | 0.69 | 0.23
-5 | 35 | -6.17 | 36.39 | -5.08 | 36.48 | -5.62 | 36.44 | -4.36 | 35.01 | 1.09 | -7.06 | 35.95 | -5.82 | 36.08 | -6.44 | 36.02 | 1.24 | 0.13
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
