ssteejans/thesis/Testing/Relative Positioning/Altitude Relative Measure/Altitude Relative Measure Calculations.xlsx

Sheet: Az=0 (4-3-18)
 | TAN | opposite length | Measured above 17deg | height above 0 | adjacent length
17 | 0.3057306815 | 388.2779655 | 0 | 388.2779655 | 1270
25 | 0.4663076582 | 592.2107259 | 204.0064498 | 388.2042761
35 | 0.7002075382 | 889.2635735 | 486.7519186 | 402.5116549
45 | 1 | 1270 | 833.9802561 | 436.0197439
 |  | 1 |  | 1
 |  | 1.525223625 |  | 0.9998102149
 |  | 2.29027566 |  | 1.036658504
 |  | 3.270852618 |  | 1.122957733

Sheet: Az=0 (4-4-18 retest)
 | Altitude Relative Position Test, Azimuth = 0°, DistanceToBoard = 1295mm
 | Command Angle [deg] | Theoretical Height Above Zero [mm] | Measured Height Above Ref [mm] | Height from Zero to Ref [mm] | % Error | Calculated Angle | Cmd Angle - Calc Angle | adjacent length | 0.00 | 0.00
0.2967059728 | 17 | 395.92 | 0 | 395.92 | 0 | 17.0000 | -4.98687693e-05 | 1295 | 75.42 | -0.58
0.3490658504 | 20 | 471.34 | 76 | 395.34 | -0.1464379949 | 20.0226 | 0.0226 |  | 140.49 | 0.49
0.3926990817 | 22.5 | 536.41 | 140 | 396.41 | 0.1225826615 | 22.4816 | -0.0184 |  | 207.95 | 2.95
0.436332313 | 25 | 603.87 | 205 | 398.87 | 0.7443866557 | 24.8928 | -0.1072 |  | 278.21 | 2.21
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
