ssteejans/thesis/Testing/Grid of Points/NumberGridPoints.png

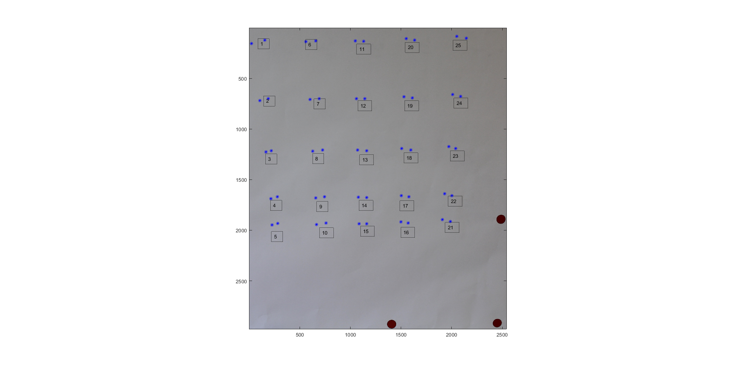
Testing/Grid of Points/NumberGridPoints.png
