ssteejans/thesis/Testing/Grid of Points/picture.jpg

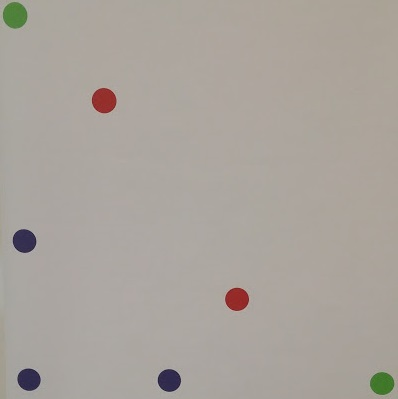
Testing/Grid of Points/picture.jpg
