ssteejans/thesis/Thesis Solidmodel/Frame Assembly - Sheet1.pdf

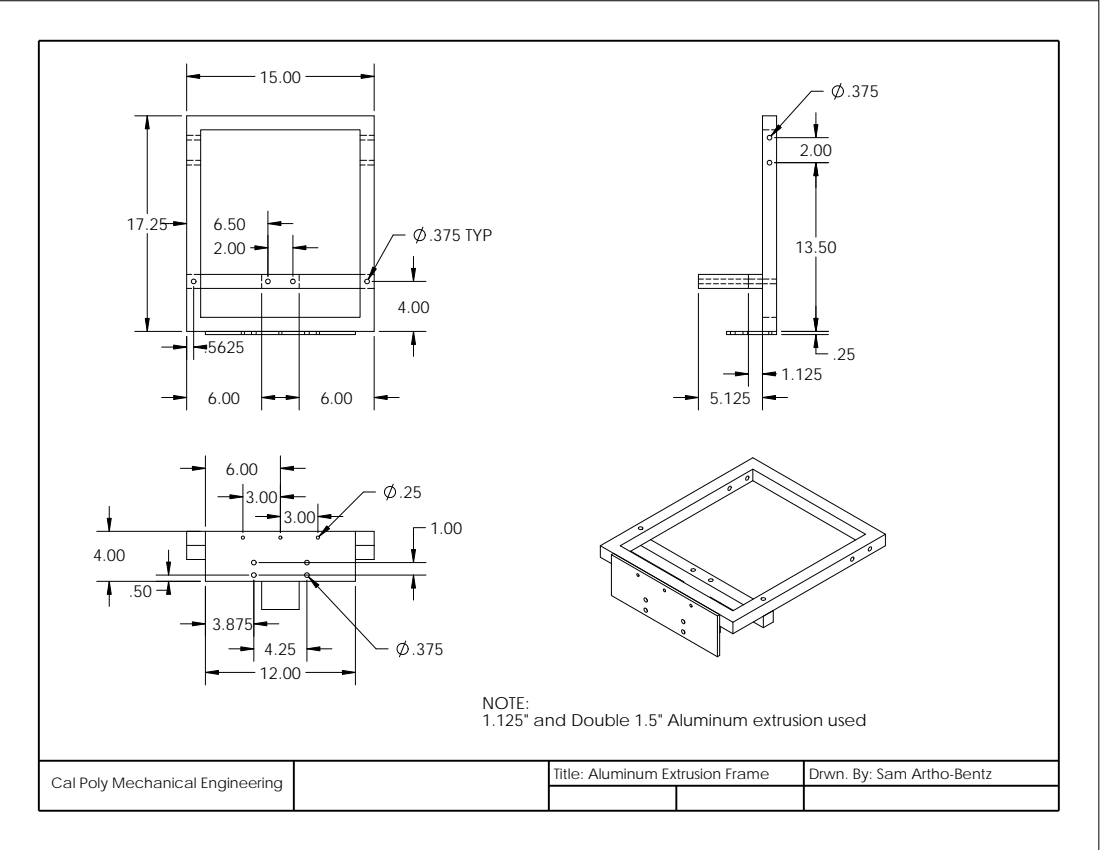
[picture p155: page 1]
.375 TYP; Title: Aluminum Extrusion Frame; Drwn. By: Sam Artho-Bentz Cal Poly Mechanical Engineering

NOTE:
1.125" and Double 1.5" Aluminum extrusion used
