ssteejans/thesis/Thesis Solidmodel/MotorSpacer - Sheet1.pdf

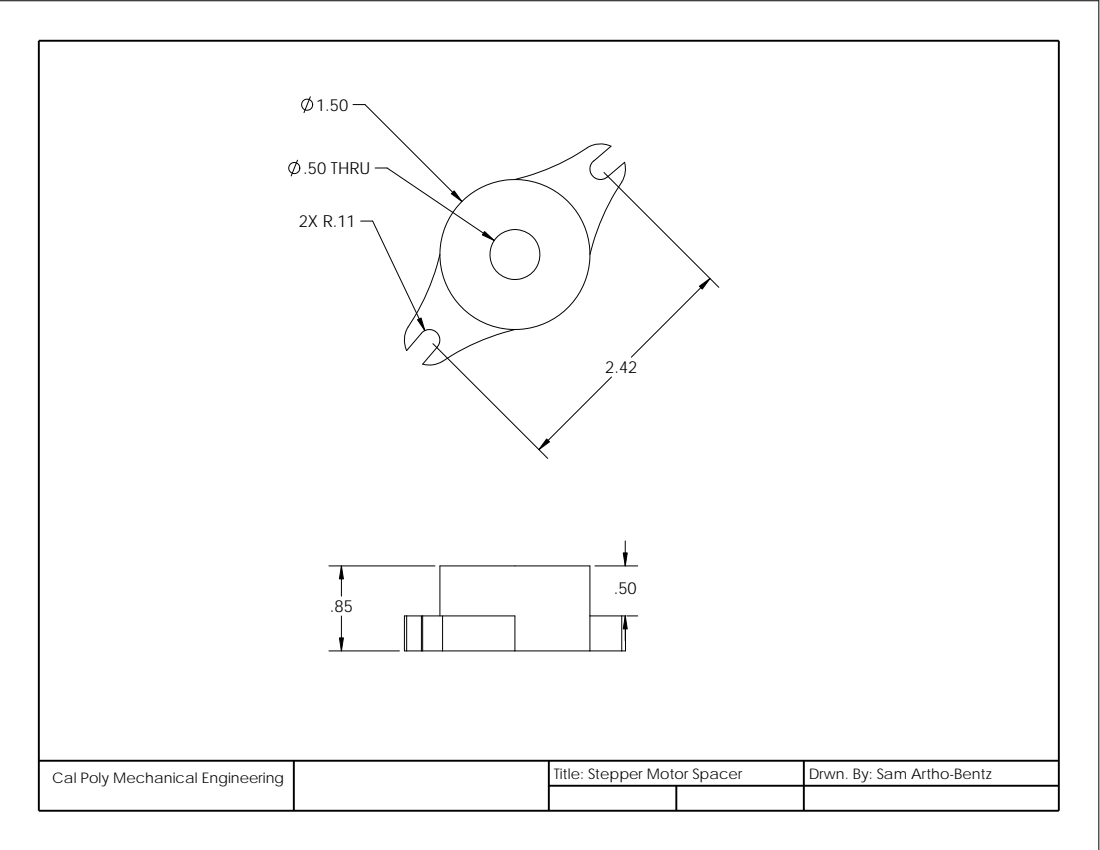
[picture p156: page 1]
.50 THRU; Cal Poly Mechanical Engineering; Title: Stepper Motor Spacer; Drwn. By: Sam Artho-Bentz
