ssteejans/thesis/Thesis Solidmodel/Stepper Conversion Plate - Shee.pdf

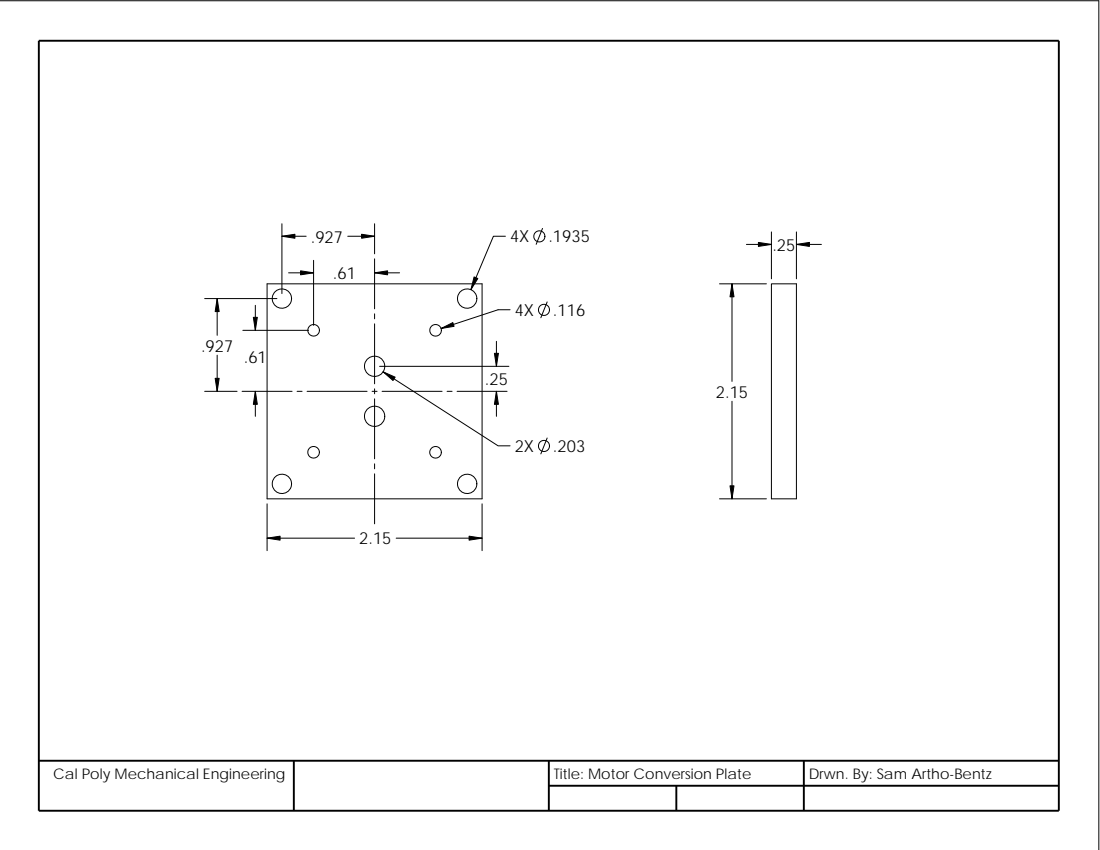
[picture p157: page 1]
Cal Poly Mechanical Engineering; Title: Motor Conversion Plate; Drwn. By: Sam Artho-Bentz
