ssteejans/thesis/Images/8020Frame - Sheet1.pdf

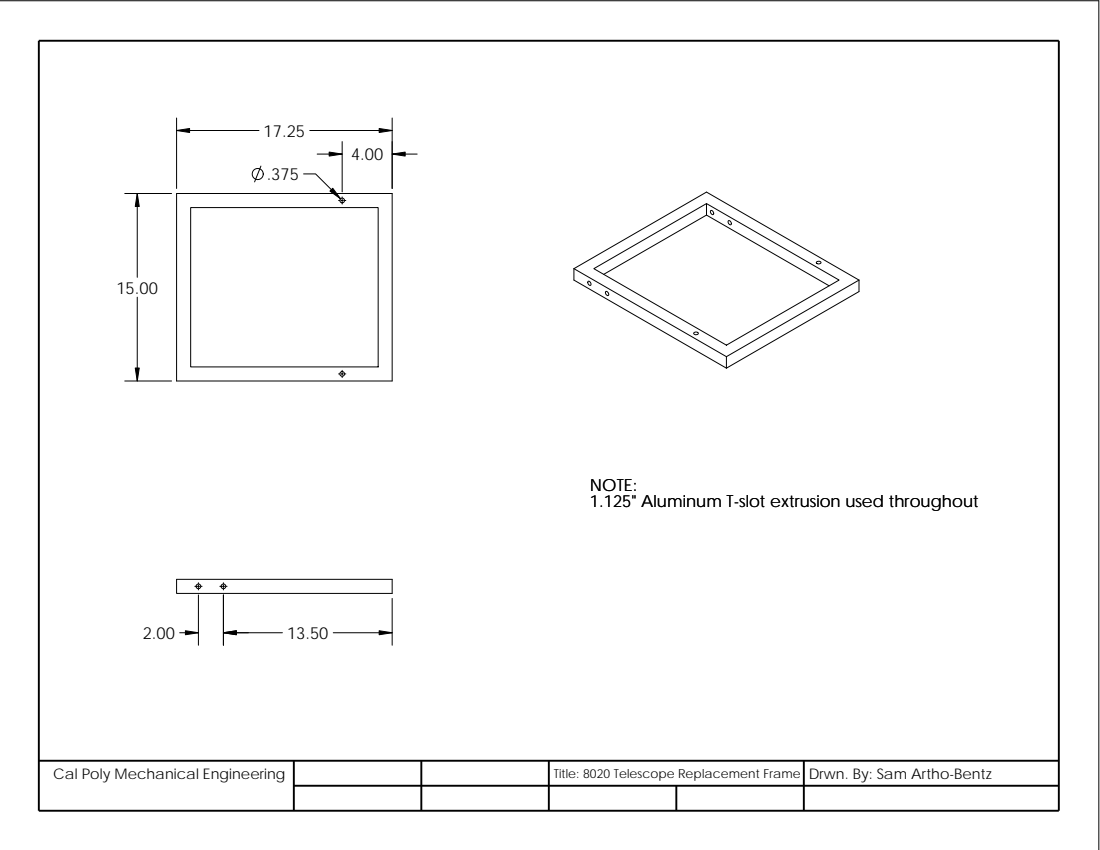
[picture p158: page 1]
Cal Poly Mechanical Engineering; Title: 8020 Telescope Replacement Frame; Drwn. By: Sam Artho-Bentz

NOTE:
1.125" Aluminum T-slot extrusion used throughout
