ssteejans/thesis/Images/Backplate - Sheet1.pdf

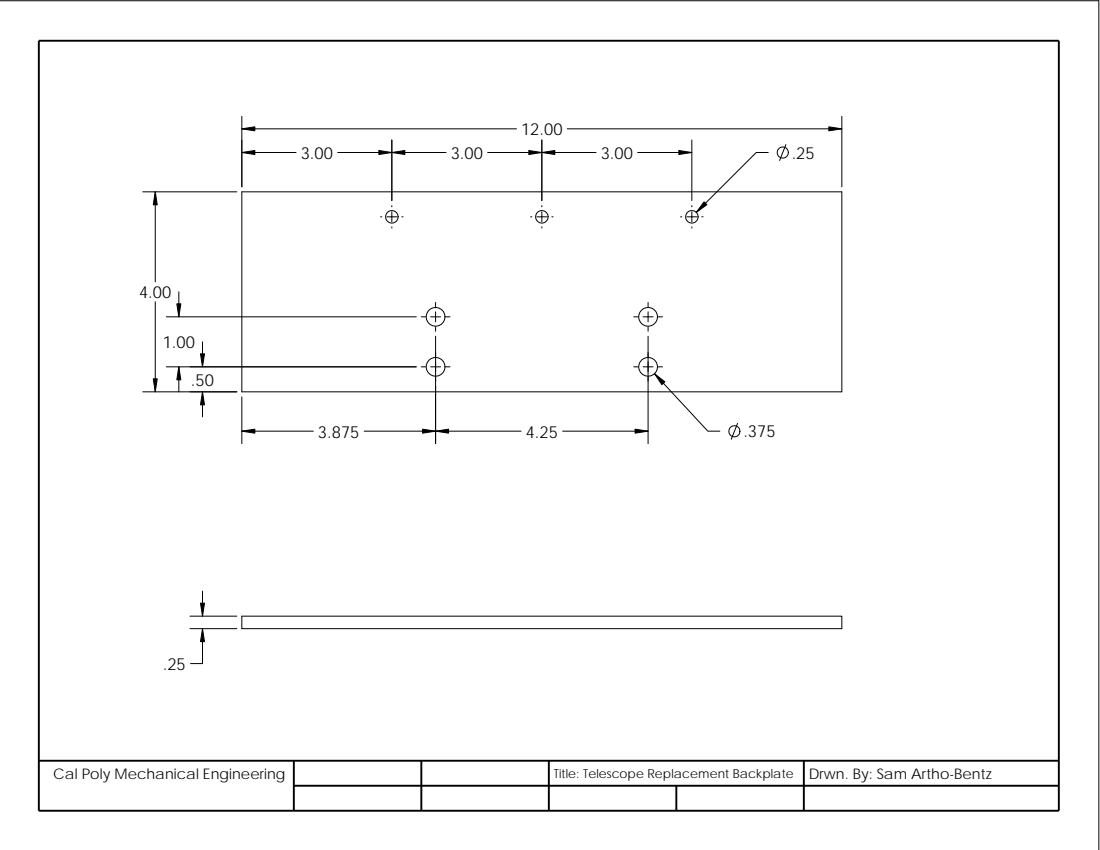
[picture p159: page 1]
Cal Poly Mechanical Engineering; Title: Telescope Replacement Backplate; Drwn. By: Sam Artho-Bentz
