ssteejans/thesis/(commit log)

2018-07-30 Added Velocity testing data with google drive link to videos.
2018-08-01 Added all testing data and links to images in google drive.
    [Altitude Relative Measure Calculations.xlsx, Azimuth Velocity Calcs.xlsx]
2018-08-02 Started entering testing info into Main Paper.docx
    [Altitude Relative Measure Calculations.xlsx, Azimuth Velocity Calcs.xlsx]
2018-09-03 Added feedback document from Ridgely Edited GridImageProcessing.m to calculate percent errors based on angle not distance found error that had made distance percent errors so wrong It looks like ther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
2018-11-17 Repaired solid model extracted images from solid model for use in final report copy/pasted matlab code into word doc to create correctly formatted and colorcoded code.
    [6960T110.SLDASM, 6960T110_Arm.SLDPRT, 6960T110_Ball.SLDPRT, 8020Frame.SLDPRT, AcmeNut.SLDPRT, AcmeRod.SLDPRT, ActuatorRotator.SLDPRT, Backplate.SLDPRT]
2018-11-18 Added altitude relative test data
    [Altitude Relative Measure Calculations.xlsx]
2018-11-19 Electronics images Old linear actuator
2018-11-22 Generated more figures. Still need to include them in the main paper
    [8020Frame.SLDDRW, AnglesDef.SLDASM, Backplate.SLDDRW, Dropdown.SLDDRW]
2019-07-08 Moved todo list to word doc for formatting Work on main paper. especially design section.
    [Altitude Relative Measure Calculations.xlsx]
2019-07-09 word crashed and lost work so I'm backing it up to make sure I don't lose more
    [Altitude Relative Measure Calculations.xlsx]
2019-07-11 velocity test table inserted
    [Velocity Tests.xlsx]
2019-07-11 "wobble" test section written to do updated.
    [Data From Matlab on img_7849.xlsx]
2019-07-11 Began updating code base to be used with doxygen. l6470nucleo.py and ActuatorDriver.py updated
    [Frame Assembly.SLDASM, Frame Assembly.SLDDRW, MotorSpacer.SLDDRW, Stepper Conversion Plate.SLDDRW]
2019-07-11 Documented ActuatorDriver.py, l6470nucleo.py, main.py, TelescopeDriver.py
2019-07-12 work on test results continues
    [Data From Matlab on img_7849.xlsx]
2019-07-13 Added equations for velocity that didn't work
2019-08-22 Added matlab image processing code for testing added sample of how bearings could be used to support axial and moment loading
    [6680K110_ANGULAR-CONTACT BALL BEARING.SLDPRT, 7549K760_RIGHT-HAND PRECISION ACME LEAD SCREW.SLDPRT, Assem1.SLDASM, bearing housing.SLDPRT]
2019-11-11 Added joint assembly images
2019-11-15 add size of 3mm to testing generate and submit rev 2 to ridgely
2020-02-03 Started additional part for bearing example Completed list of required changes as per Ridgely
    [Assem1.SLDASM, Bearing retainer.SLDPRT]
2020-06-30 even more. so close to done
    [6680K110_ANGULAR-CONTACT BALL BEARING.SLDPRT, 7549K760_RIGHT-HAND PRECISION ACME LEAD SCREW.SLDPRT, Assem1.SLDASM, Bearing retainer.SLDPRT, bearing housing.SLDPRT]
2020-07-02 Begin presentation
    [Assem1.SLDASM, BaseBearing.SLDPRT, MotorBasePlate.SLDPRT, MotorHinge.SLDPRT, MotorRotator.SLDPRT, shaft.SLDPRT, shaftBearing.SLDPRT]
